ValoulouEtGab/PolyMecanum/Images/20240202_102125.jpg

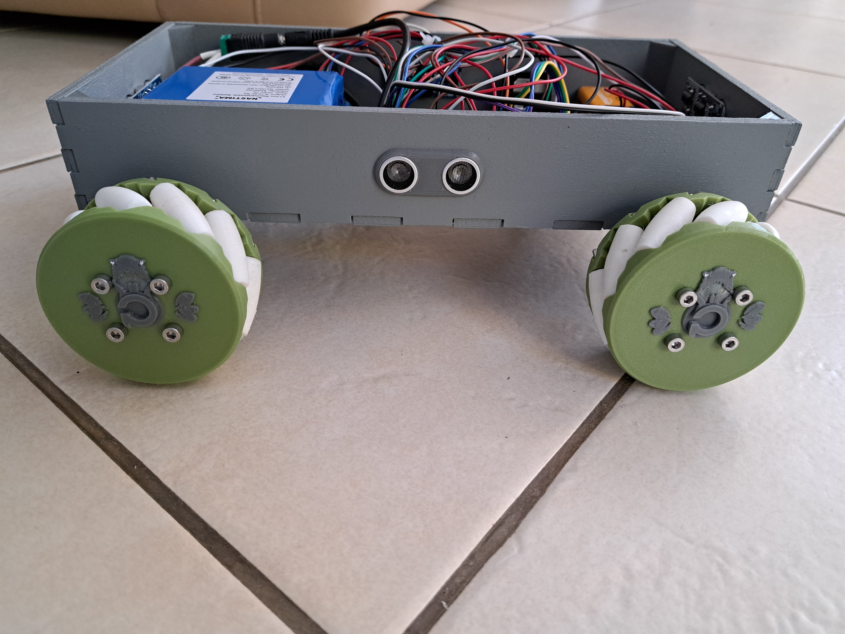
Images/20240202_102125.jpg
