ValoulouEtGab/PolyMecanum/README.md

# PolyMecanum
Plateforme contrôlée depuis un smartphone avec des roues "Mecanum".
