ValoulouEtGab/PolyMecanum/Rapport Final/Rapport Final PolyMecanum.pdf

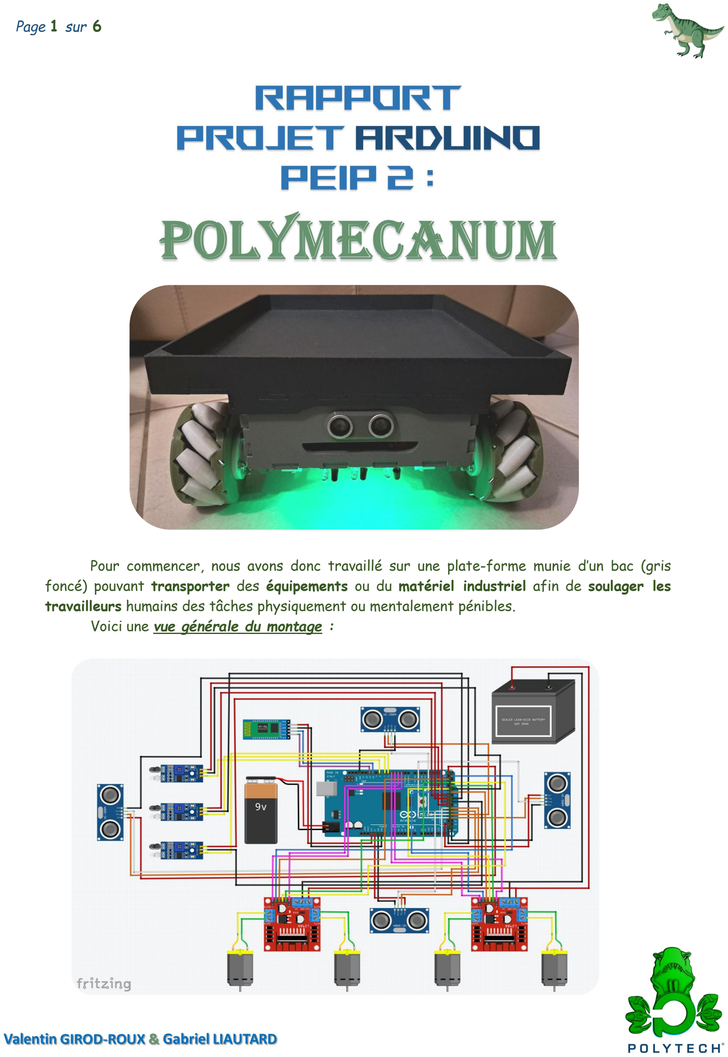
[picture p3: page 1]

Page 1 sur 6

Pour commencer, nous avons donc travaillé sur une plate-forme munie d’un bac (gris foncé) pouvant transporter des équipements ou du matériel industriel afin de soulager les travailleurs humains des tâches physiquement ou mentalement pénibles. Voici une vue générale du montage :

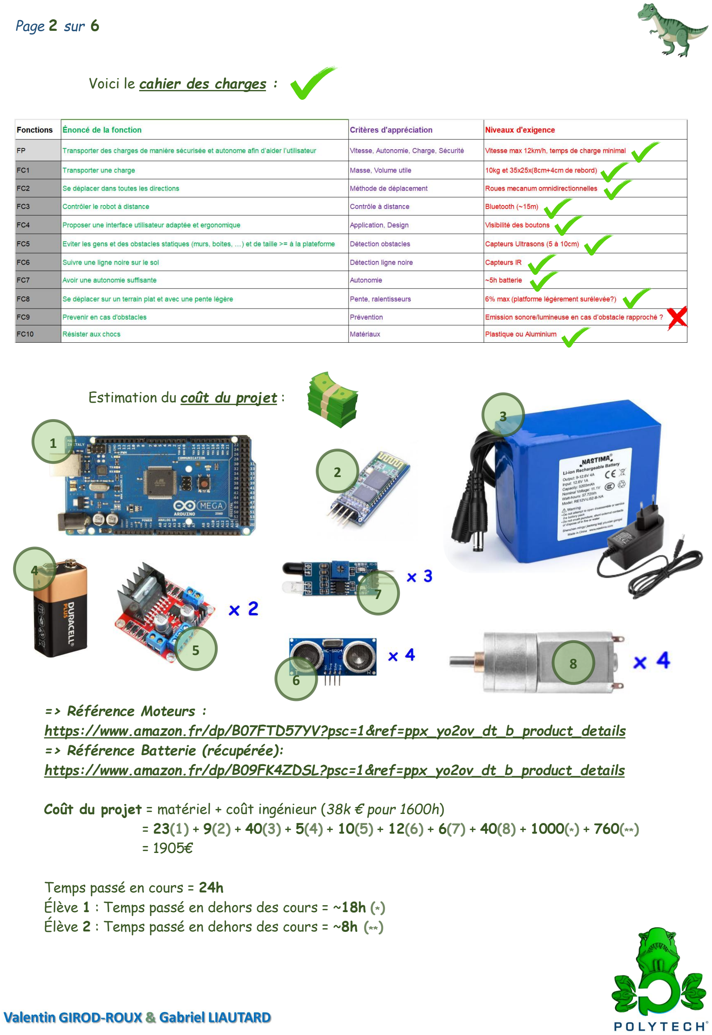
[picture p4: page 2]

Page 2 sur 6

Voici le cahier des charges :

Estimation du coût du projet :

=> Référence Moteurs :
https://www.amazon.fr/dp/B07FTD57YV?psc=1&ref=ppx_yo2ov_dt_b_product_details => Référence Batterie (récupérée):

https://www.amazon.fr/dp/B09FK4ZDSL?psc=1&ref=ppx_yo2ov_dt_b_product_details

Coût du projet = matériel + coût ingénieur (38k € pour 1600h) = 23(1) + 9(2) + 40(3) + 5(4) + 10(5) + 12(6) + 6(7) + 40(8) + 1000(*) + 760(**) = 1905€

Temps passé en cours = 24h
Élève 1 : Temps passé en dehors des cours = ~18h (*) Élève 2 : Temps passé en dehors des cours = ~8h (**)

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
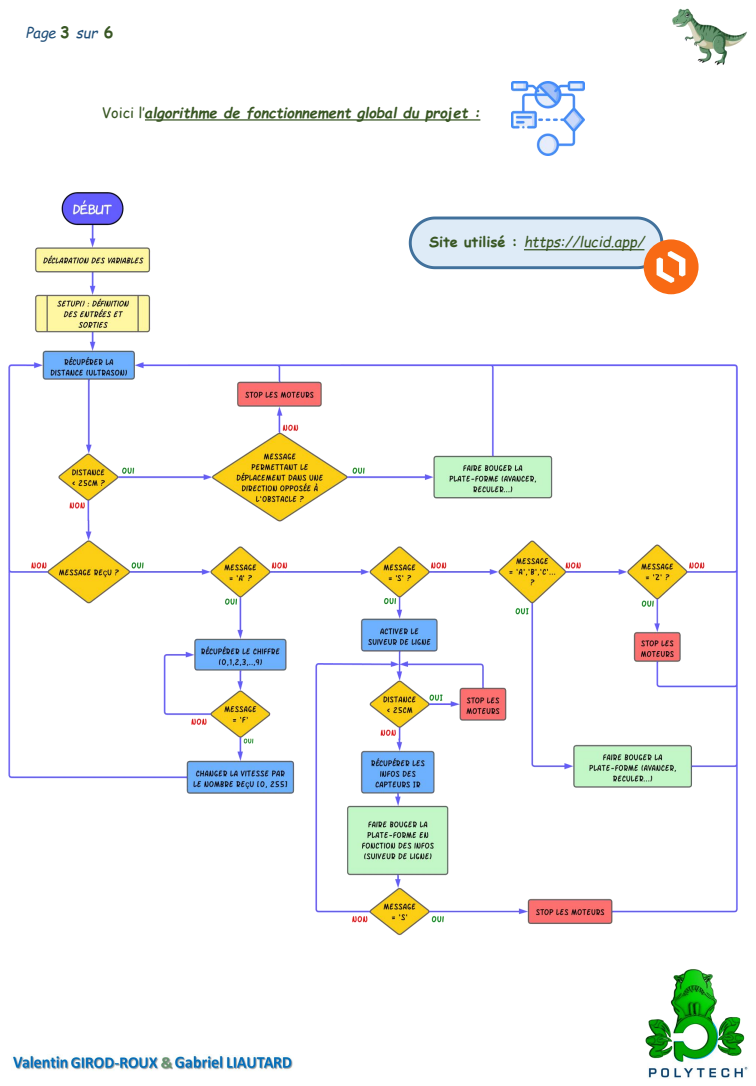
[picture p5: page 3]
Page 3 sur 6

Voici l’algorithme de fonctionnement global du projet :

Site utilisé : https://lucid.app/

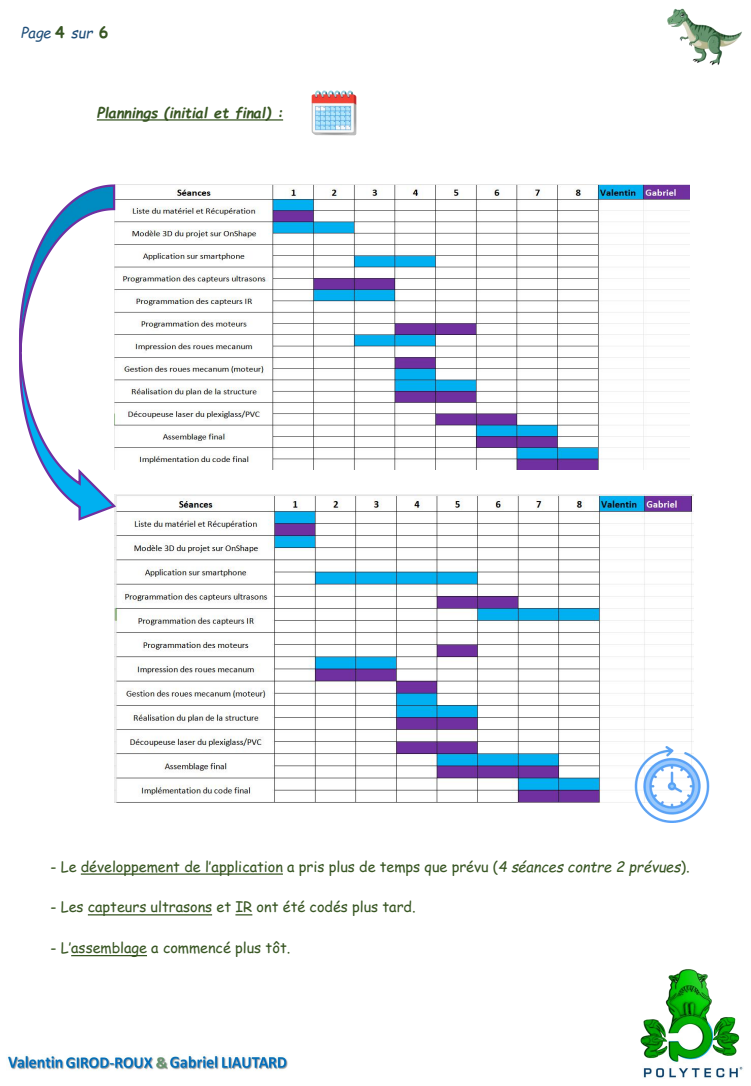
[picture p6: page 4]
Page 4 sur 6

Plannings (initial et final) :

- Le développement de l’application a pris plus de temps que prévu (4 séances contre 2 prévues). - Les capteurs ultrasons et IR ont été codés plus tard. - L’assemblage a commencé plus tôt.

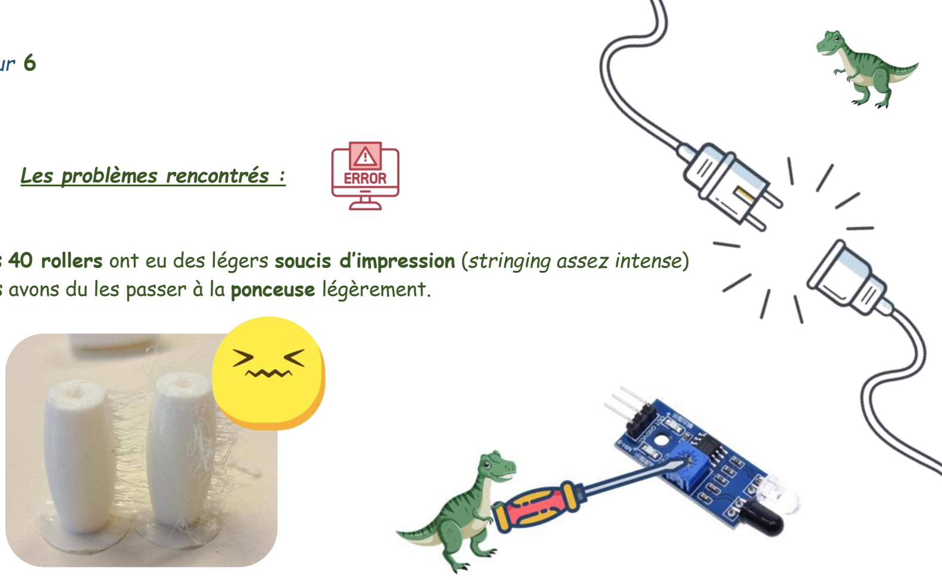
[picture p7: figure]
Les problèmes rencontrés :

Page 5 sur 6

- Les 40 rollers ont eu des légers soucis d’impression (stringing assez intense) Nous avons du les passer à la ponceuse légèrement.
- Le réglage des capteurs IR étaient trop sensibles avec le potentiomètre et 1 des capteurs ne fonctionnait pas car il manquait une LED. - Lorsque nous faisions rouler la plate-forme dans le couloir, les roues se détachaient de l’axe

du moteur donc nous avons rajouté une vis afin de serrer celui-ci.

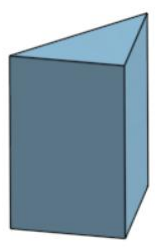
[picture p8: figure]
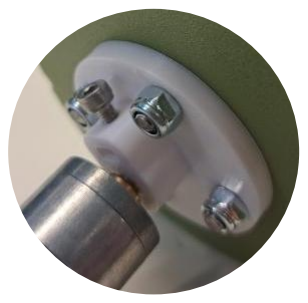
[picture p9: figure]

- Afin de rigidifier la structure nous avons rajouté des triangles en TPU dans les angles. - Il n’y avait plus de pins 5V donc nous avons branché les alimentations des capteurs sur des

pins digitaux (0/1) et nous les avons mis en HIGH. - Les capteurs ne fonctionnaient plus

à cause du manque de voltage de la pile 9V.

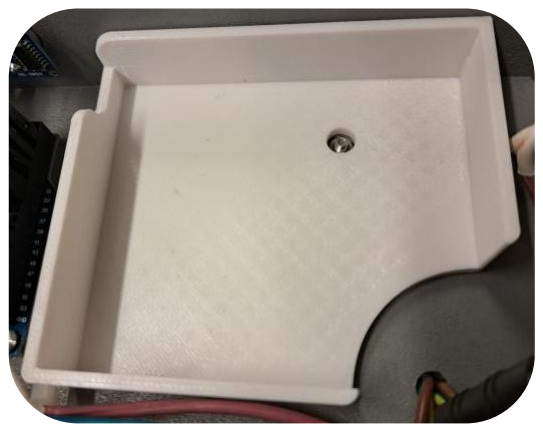
[picture p10: figure]

- La batterie faisait du bruit lors du déplacement donc nous avons imprimé un support en PLA. - Le bac faisait également du bruit donc nous avons recouvert tout le tour de feutrine.

Page 6 sur 6

Bibliographie :

Le design des roues a été pris sur : https://howtomechatronics.com/projects/arduino-mecanum-wheels-robot/
L’application a été réalisé sur : https://appinventor.mit.edu/

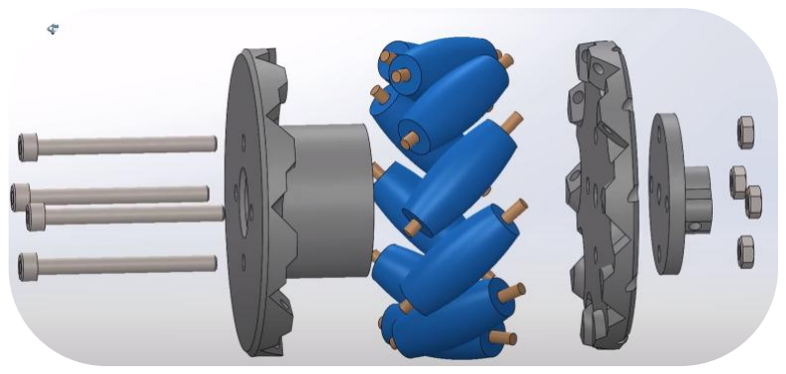
[picture p11: figure]

# CONCLUSION :

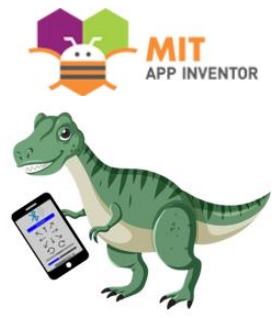
[picture p12: figure]

En résumé, notre projet nous a permis de mettre en pratique les compétences acquises en PEIP dans les différentes matières. L'utilisation de ce type de roue, d'un contrôle à distance, d'une détection d'obstacles et

d’un suiveur de ligne rend ce système polyvalent, adapté aussi bien à des applications industrielles que domotiques. Enfin, pour améliorer le suiveur de ligne, une caméra pourrait servir à prévoir les virages plus

précisément. Si nous avions eu encore plus de temps, nous arions pu monter à l’arrière un bras avec des servomoteurs et une pince afin de récupérer les équipements. Nous arions pu aussi implémenter de l’IA pour éviter les obstacles de manière autonome.

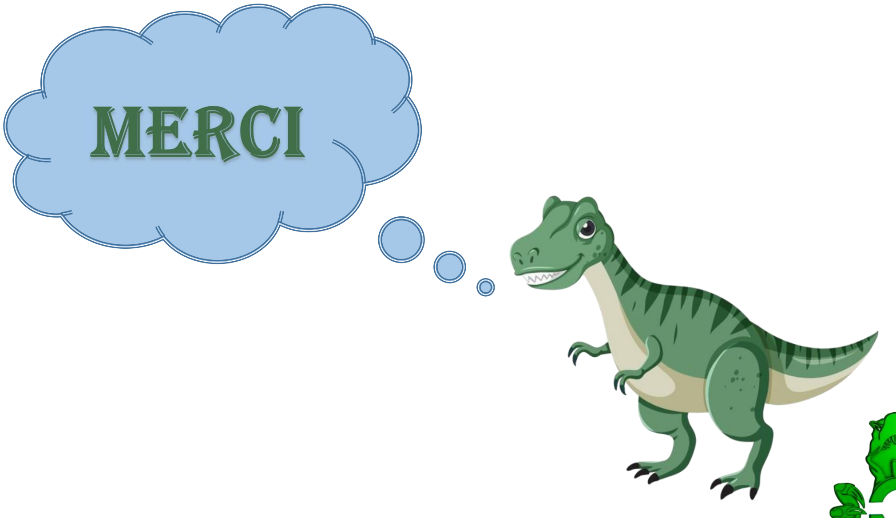
[picture p13: figure]
