ValoulouEtGab/PolyMecanum/Rapports de seances/7 - GIROD-ROUX.pdf

## RAPPORT DE SEANCE 7 :

Durant la septième séance nous avons installé les capteurs infrarouges en dessous de la plate-forme à l’avant. Nous les avons vissés et branchés sur les pins de la carte arduino.

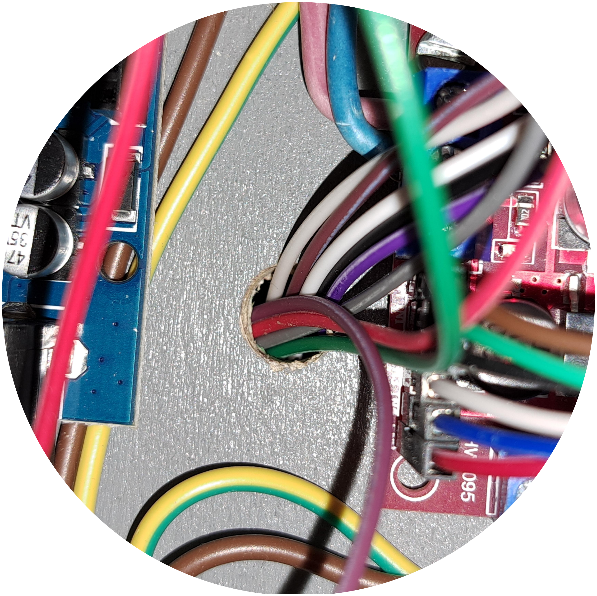
[picture p14: figure]
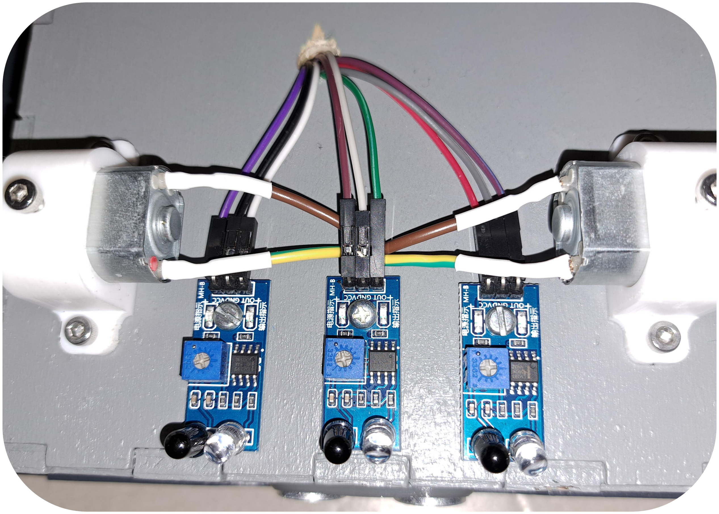
[picture p15: figure]
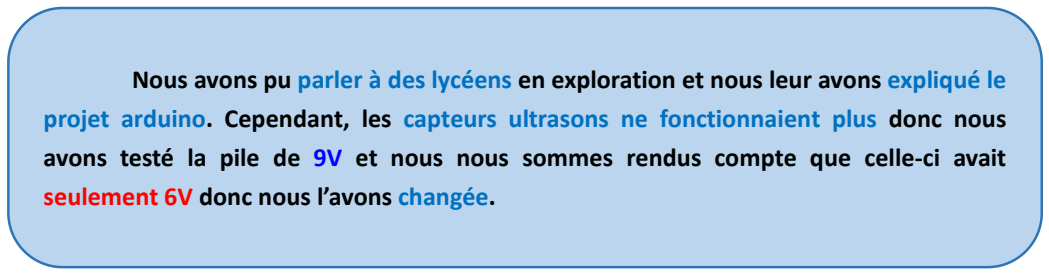
[picture p16: figure]
seulement 6V donc nous l’avons changée.

Nous avons pu parler à des lycéens en exploration et nous leur avons expliqué le projet arduino. Cependant, les capteurs ultrasons ne fonctionnaient plus donc nous avons testé la pile de 9V et nous nous sommes rendus compte que celle-ci avait

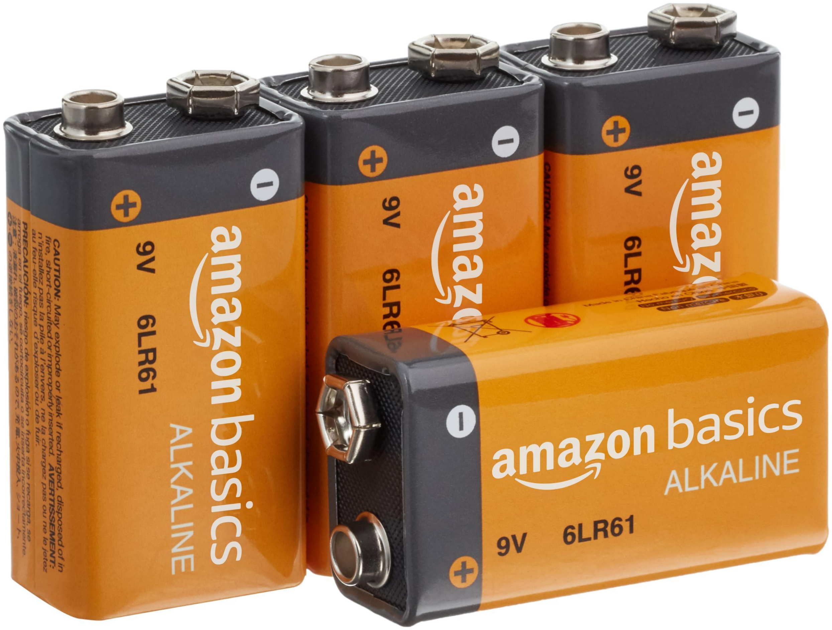
[picture p17: figure]
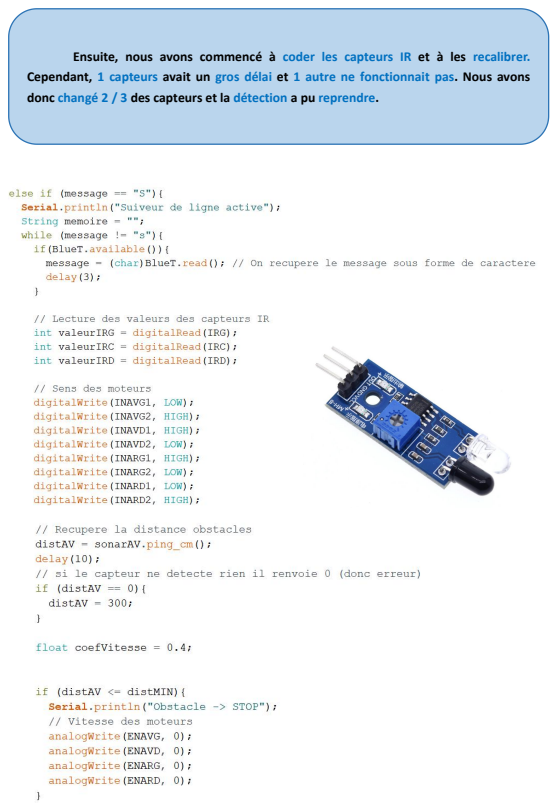
[picture p18: page 2]

Ensuite, nous avons commencé à coder les capteurs IR et à les recalibrer. Cependant, 1 capteurs avait un gros délai et 1 autre ne fonctionnait pas. Nous avons

donc changé 2 / 3 des capteurs et la détection a pu reprendre.

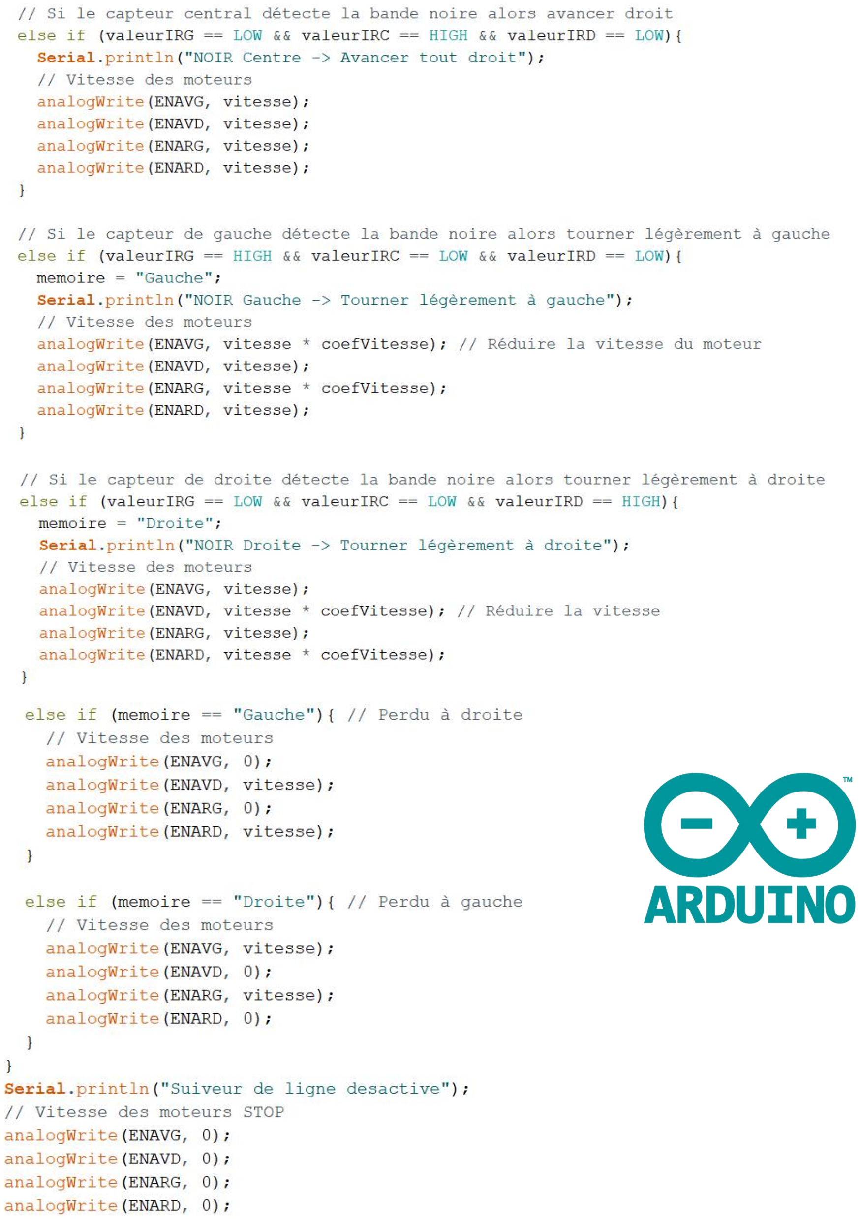
[picture p19: figure]
