ValoulouEtGab/PolyMecanum/Rapports de seances/2_LIAUTARD.pdf

## RAPPORT DE SEANCE 2 :

J’ai commencé à combiner les codes que nous avions pour la voiture (code moteur, code capteur ultrasons, code infrarouge pour suivre ligne noire, module bluetooth) de manière à les réorganiser pour pouvoir remplir notre cahier des charges, c’est à dire : pouvoir avoir un véhicule qui s’arrête s’il s’approche trop près d’un mur, qu’il y ait un mode permettant de suivre un chemin tout tracé via une ligne noire au sol, et que le véhicule puisse être contrôlable à distance. Etant donné que nous avons 4 capteurs ultrasons, 3 capteurs infrarouges et un

module bluetooth, combiner le tout est une tâche ardue qui va prendre du temps et nécessiter beaucoup de concentration pour recoller les morceaux :

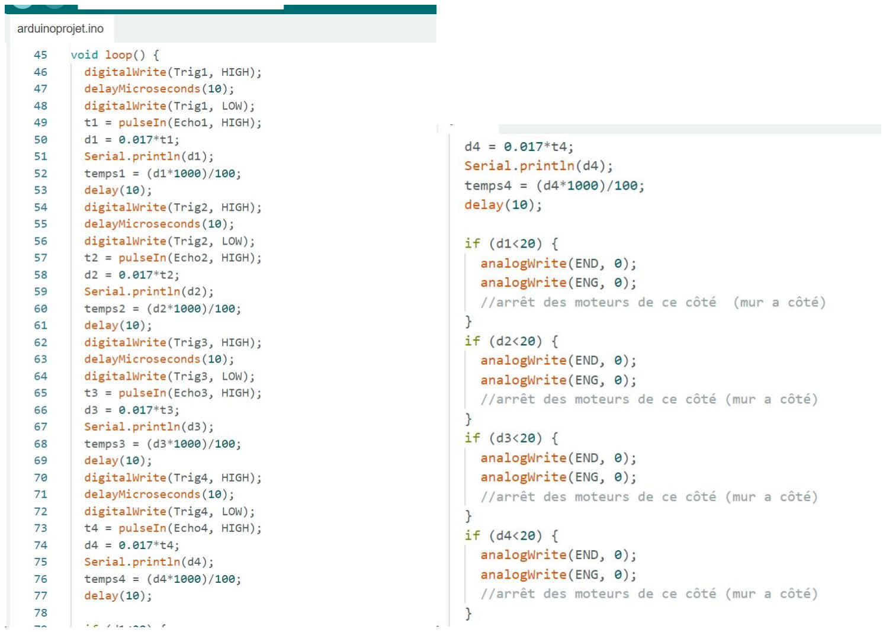
[picture p39: figure]

Nous sommes allés au Fab Lab afin de lancer l’impression des roues mecanum. Nous avons décidé d’imprimer la structure des roues en PLA (plastique dur, résistant) et les rollers en TPU (plastique flexible avec une meilleure adhérence au sol).

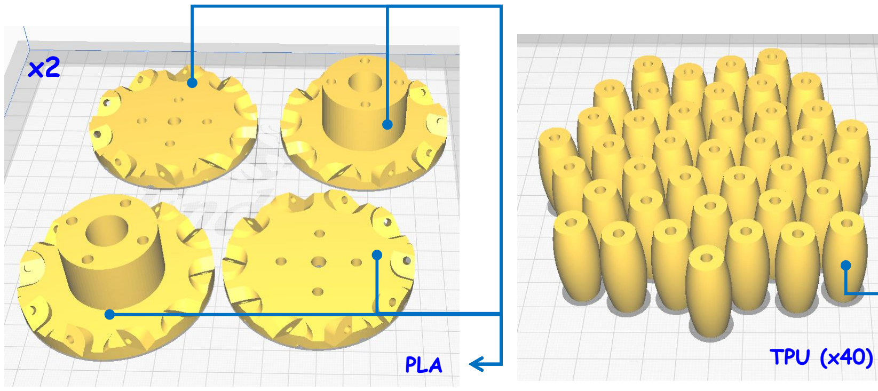
[picture p40: figure]
TPU (x40) PLA
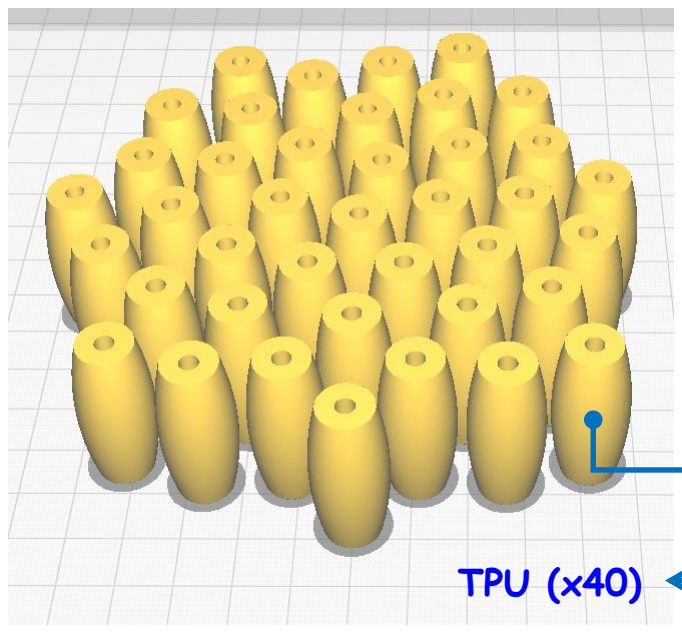
[picture p41: figure]

Nous nous sommes servis du logiciel Prusa afin de positionner les différentes parties sur le plateau. Les quatre roues munies de son armée de 40 rollers prennent environ 20h d’impression !

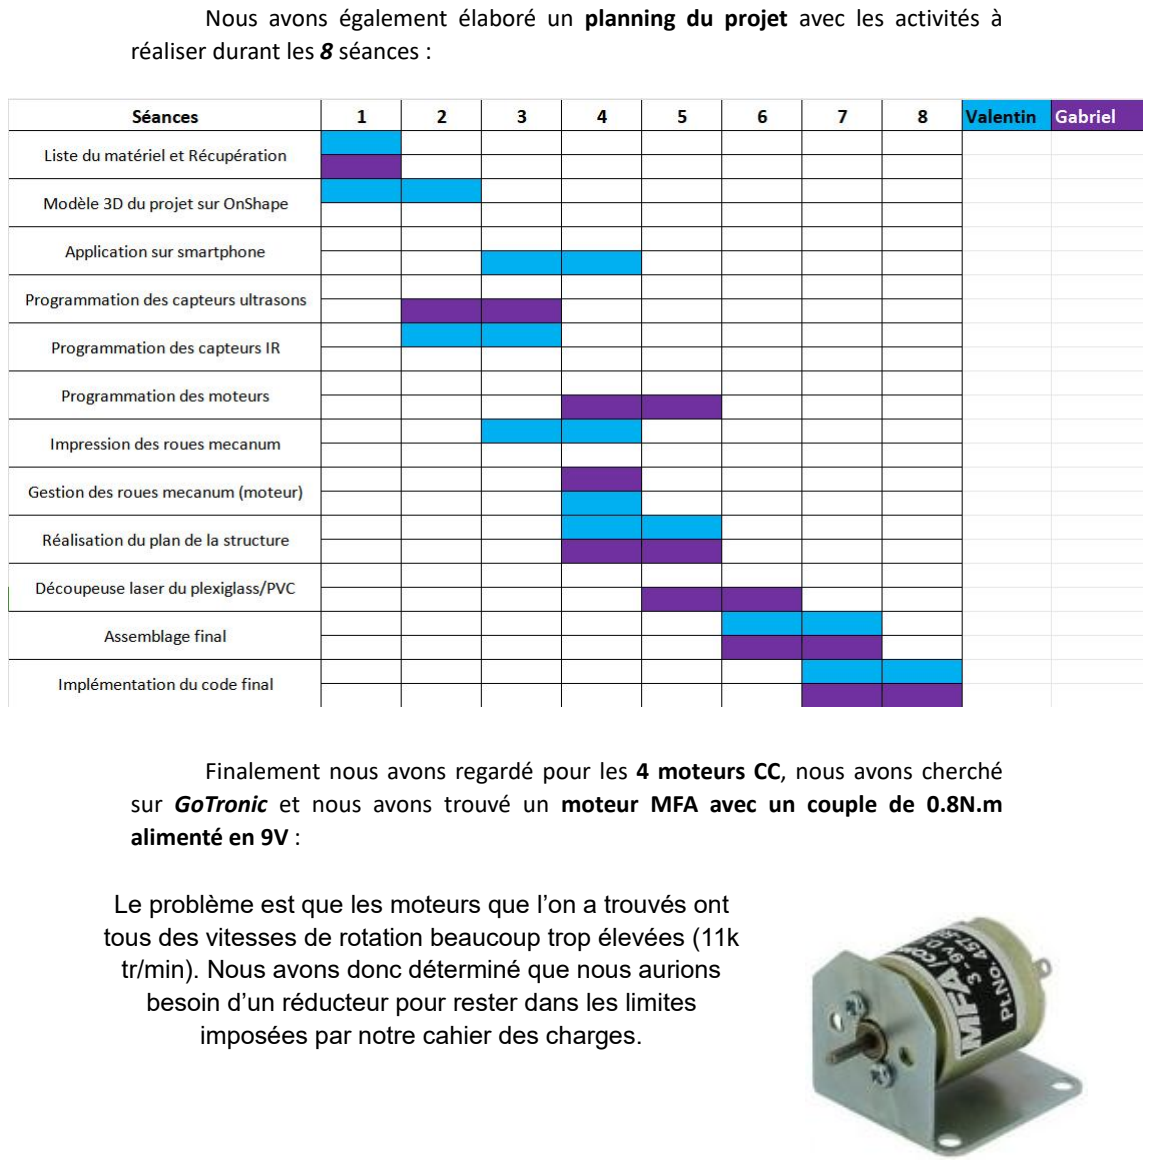
[picture p42: page 3]

Nous avons également élaboré un planning du projet avec les activités à réaliser durant les 8 séances :

Finalement nous avons regardé pour les 4 moteurs CC, nous avons cherché sur GoTronic et nous avons trouvé un moteur MFA avec un couple de 0.8N.m alimenté en 9V :

Le problème est que les moteurs que l’on a trouvés ont
tous des vitesses de rotation beaucoup trop élevées (11k
tr/min). Nous avons donc déterminé que nous aurions besoin d’un réducteur pour rester dans les limites imposées par notre cahier des charges.
