ValoulouEtGab/PolyMecanum/Rapports de seances/2 - GIROD-ROUX.pdf

## RAPPORT DE SEANCE 2 :

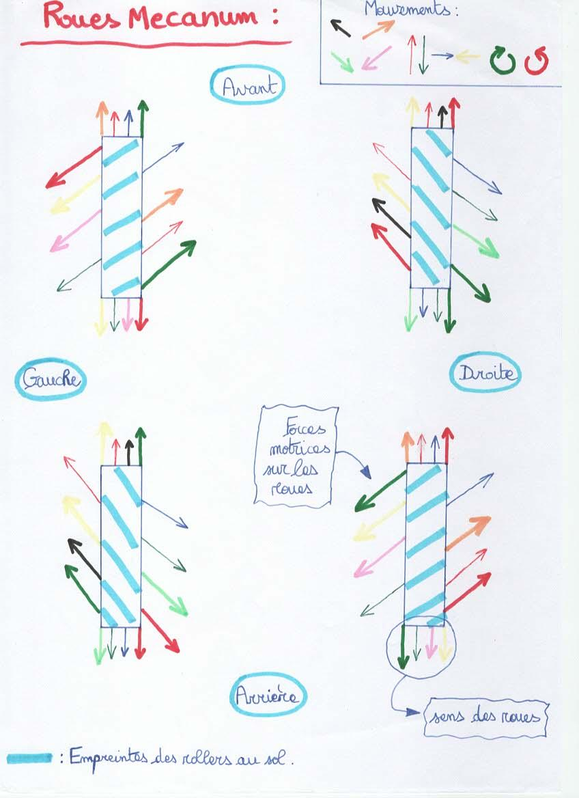
[picture p43: page 1]

Durant la deuxième séance j’ai étudié le fonctionnement des roues mecanum pour la gestion de rotation des moteurs :

x2

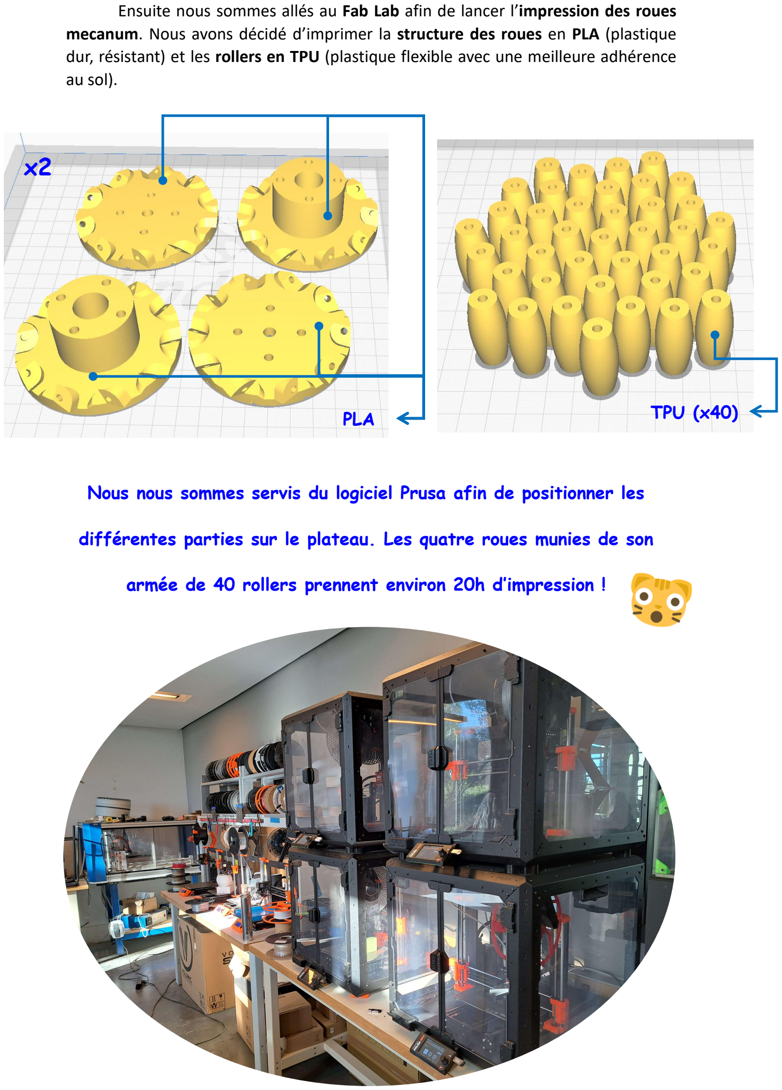
[picture p44: page 2]

Ensuite nous sommes allés au Fab Lab afin de lancer l’impression des roues mecanum. Nous avons décidé d’imprimer la structure des roues en PLA (plastique dur, résistant) et les rollers en TPU (plastique flexible avec une meilleure adhérence au sol).

Nous nous sommes servis du logiciel Prusa afin de positionner les

différentes parties sur le plateau. Les quatre roues munies de son

armée de 40 rollers prennent environ 20h d’impression !

TPU (x40) PLA

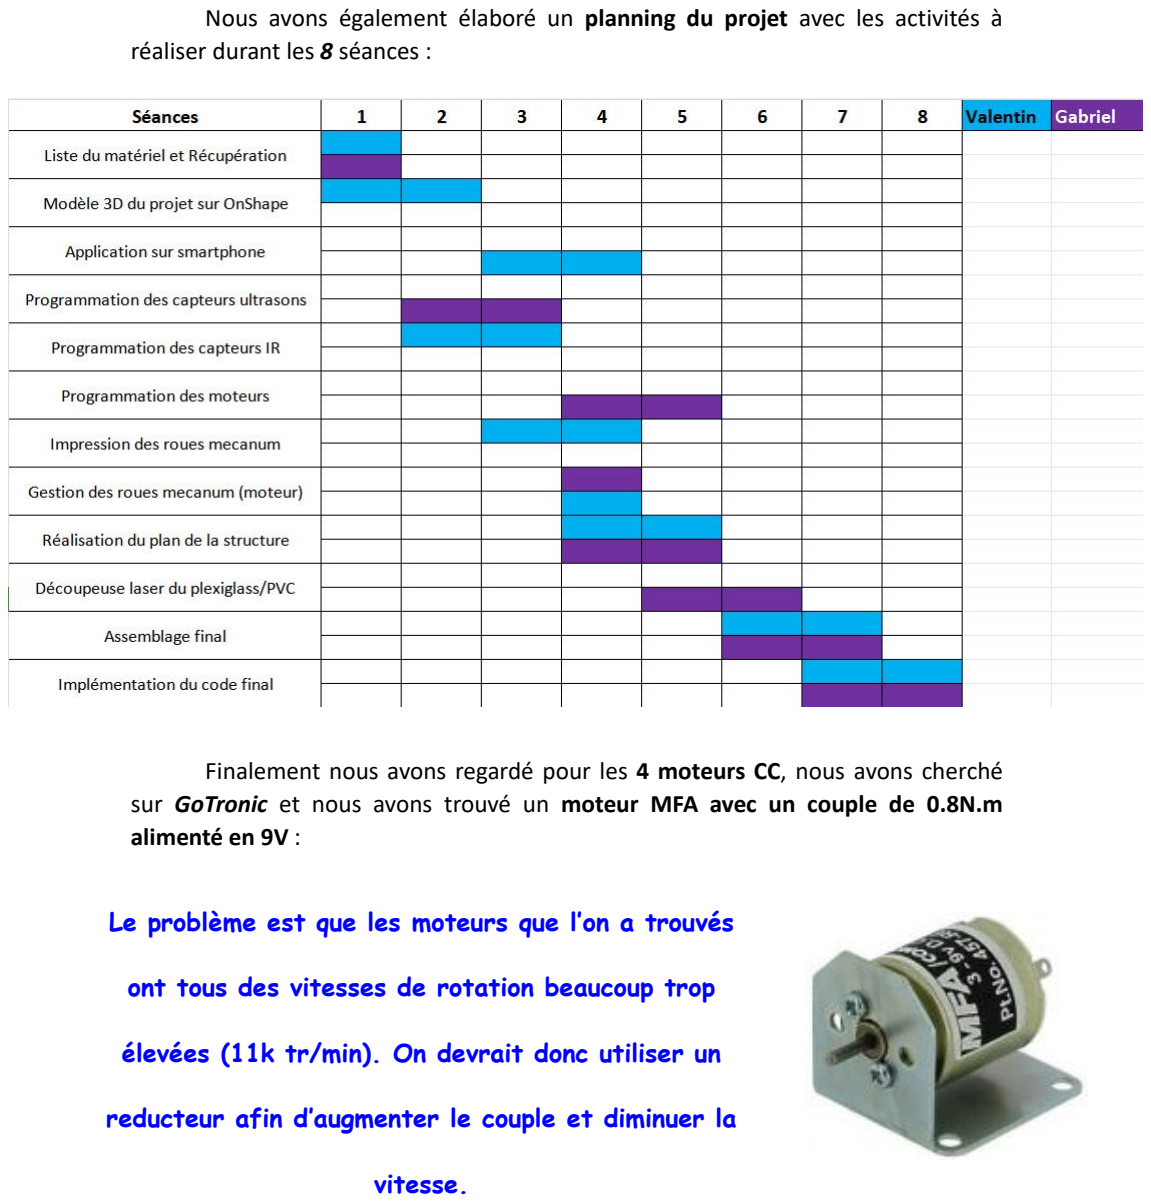
[picture p45: page 3]

Nous avons également élaboré un planning du projet avec les activités à réaliser durant les 8 séances :

Finalement nous avons regardé pour les 4 moteurs CC, nous avons cherché sur GoTronic et nous avons trouvé un moteur MFA avec un couple de 0.8N.m alimenté en 9V :

Le problème est que les moteurs que l’on a trouvés

ont tous des vitesses de rotation beaucoup trop

élevées (11k tr/min). On devrait donc utiliser un

reducteur afin d’augmenter le couple et diminuer la

vitesse.

J’ai également commencé à réaliser l’application avec le site "AppInventor" qui permettra de contrôler la plate-forme à distance.

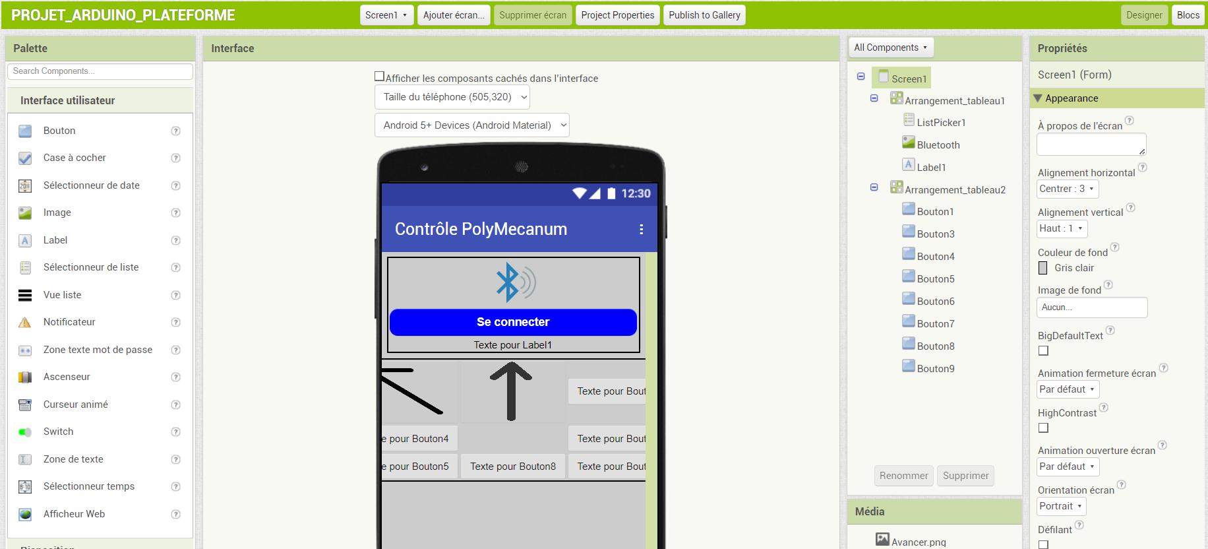
[picture p46: figure]
