ValoulouEtGab/PolyMecanum/Rapports de seances/1-LIAUTARD.pdf

## RAPPORT DE SEANCE 1 :

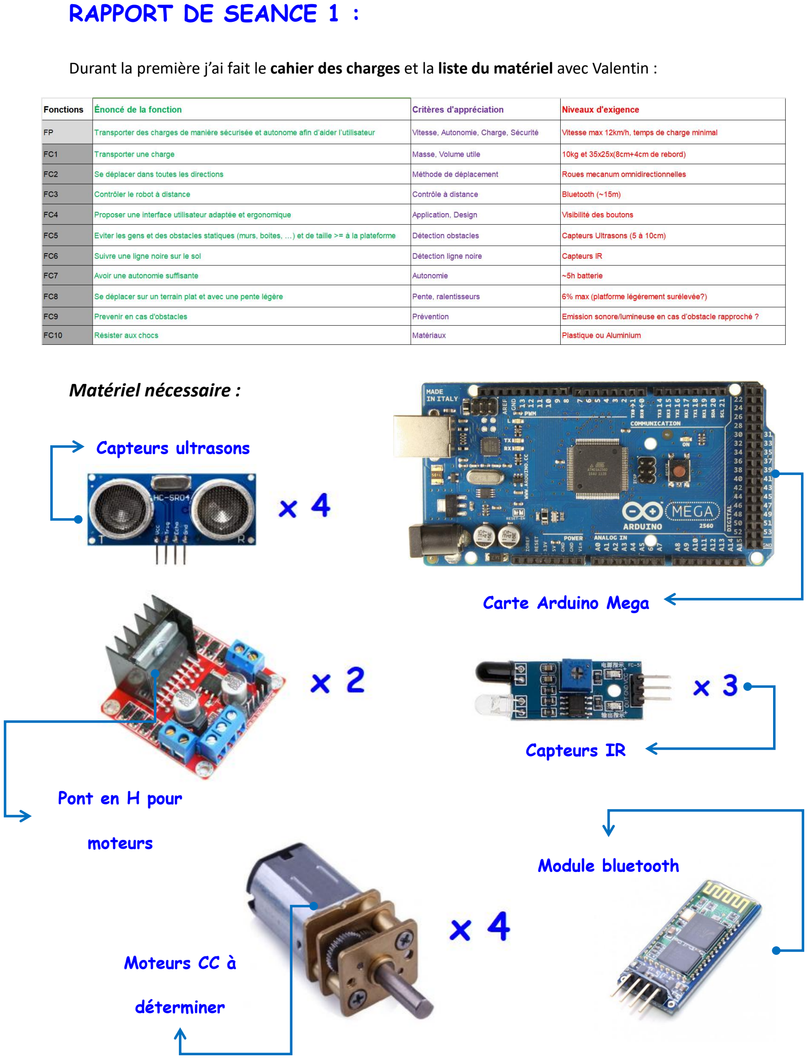
[picture p47: page 1]

Durant la première j’ai fait le cahier des charges et la liste du matériel avec Valentin :

### Matériel nécessaire :

Moteurs CC à

déterminer

Pont en H pour

moteurs
Module bluetooth

Capteurs IR

Carte Arduino Mega

Capteurs ultrasons

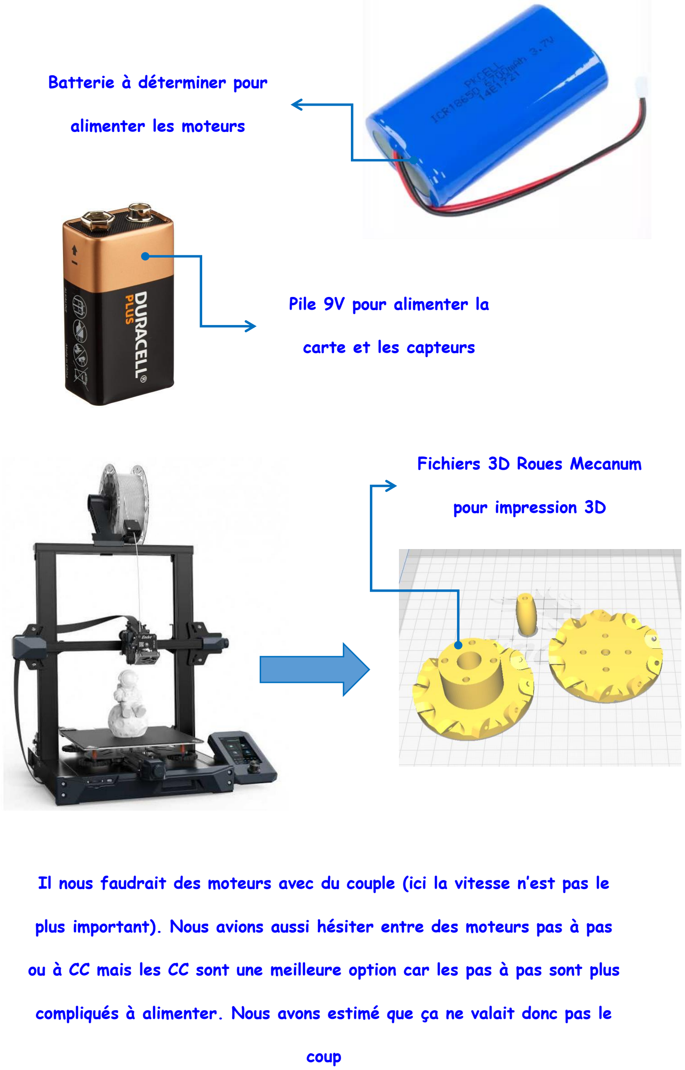
[picture p48: page 2]

Pile 9V pour alimenter la

carte et les capteurs

Batterie à déterminer pour

alimenter les moteurs

Fichiers 3D Roues Mecanum

pour impression 3D

Il nous faudrait des moteurs avec du couple (ici la vitesse n’est pas le

plus important). Nous avions aussi hésiter entre des moteurs pas à pas

ou à CC mais les CC sont une meilleure option car les pas à pas sont plus

compliqués à alimenter. Nous avons estimé que ça ne valait donc pas le

coup

Bien que c’était Valentin qui se chargeait de la modélisation OneShape, nous nous penchions tout les deux sur le problème : mesure des composants pour pouvoir reporter leur taille dans le logiciel, comment organiser l’espace et agencer les composants de manière à pouvoir avoir un produit fini compact (plus petit volume -> moins de matière -> masse du système réduite -> la masse de la charge transportée peut être plus élevée) également nous avons pensé a aménager la boite de manière a pouvoir positionner les roues plus bas. Enfin, étant donné que nous n’avions pas encore les moteurs, j’ai rassemblé des fils de même

couleurs et les ait cablé sur les composants, de manière à ce que lors des prochaines séances, assembler | les | composants | ensemble | devienne | une | tâche | plus | simple

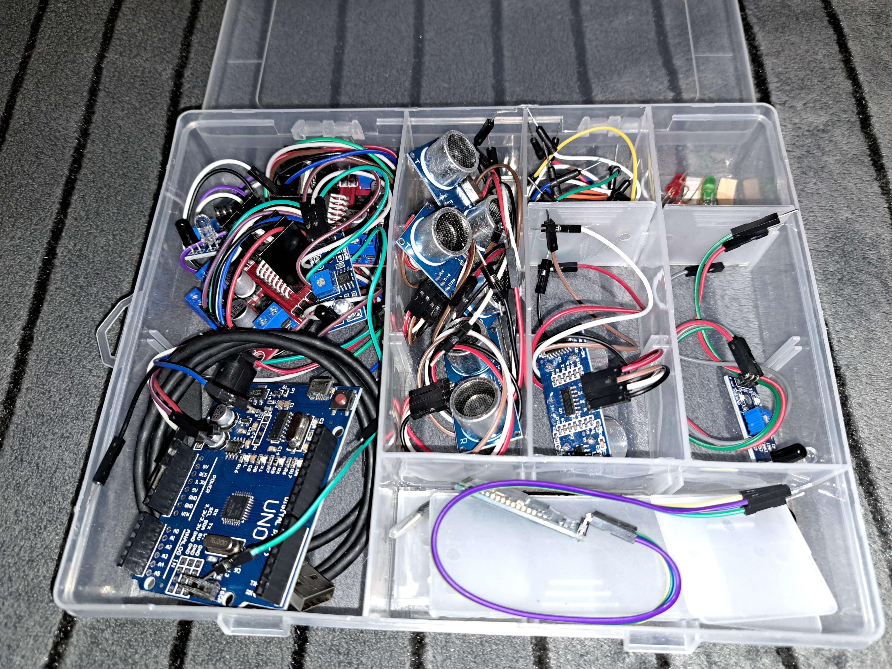
[picture p49: figure]

En somme, dans cette séance nous avons, à deux, pensé et imaginé notre

projet pour le retranscrire en 3D de manière virtuelle.
