ValoulouEtGab/PolyMecanum/Images/20240108_152602.jpg

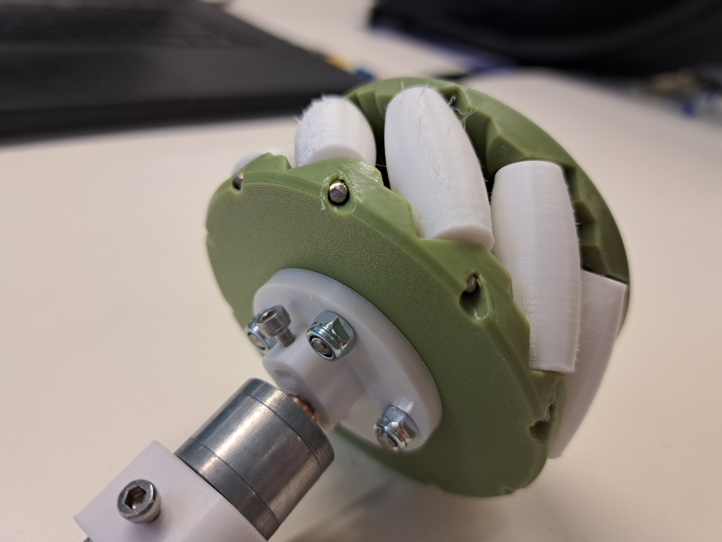
Images/20240108_152602.jpg
