ValoulouEtGab/PolyMecanum/Images/20240115_151331.jpg

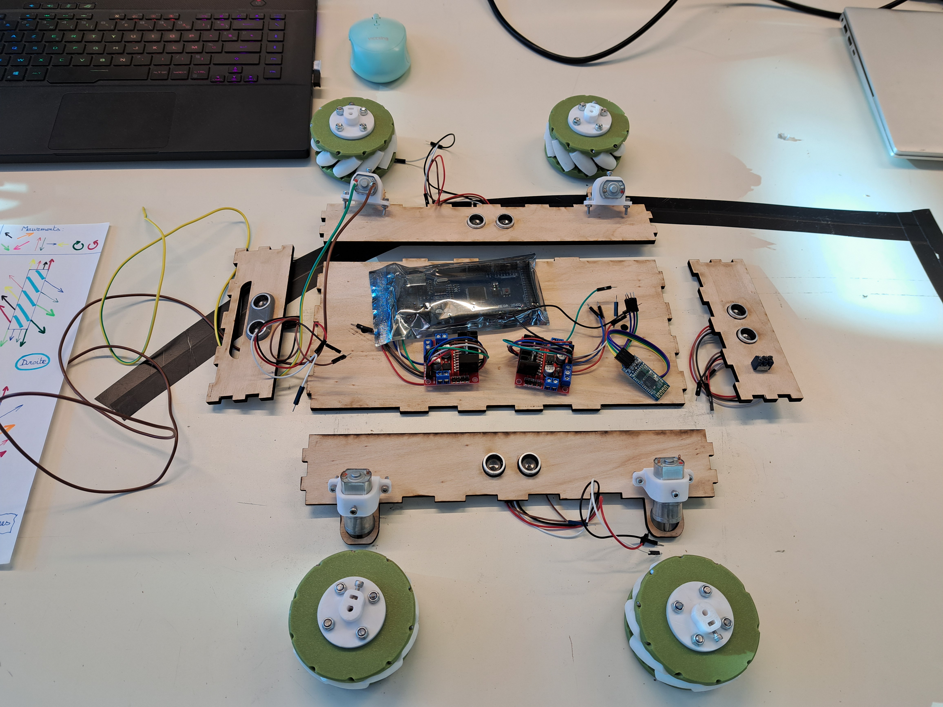
Images/20240115_151331.jpg
