ValoulouEtGab/PolyMecanum/Images/image_2024-02-27_185253469-removebg-preview.png

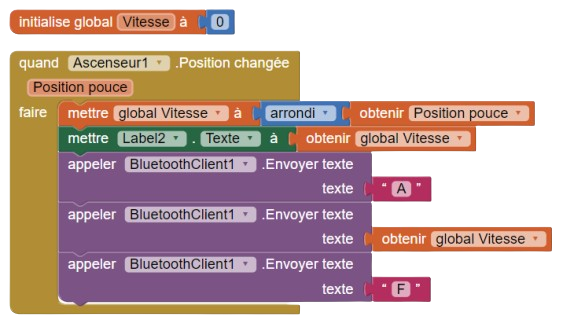
Images/image_2024-02-27_185253469-removebg-preview.png
