ValoulouEtGab/PolyMecanum/Images/Screenshot_20240227-193318.png

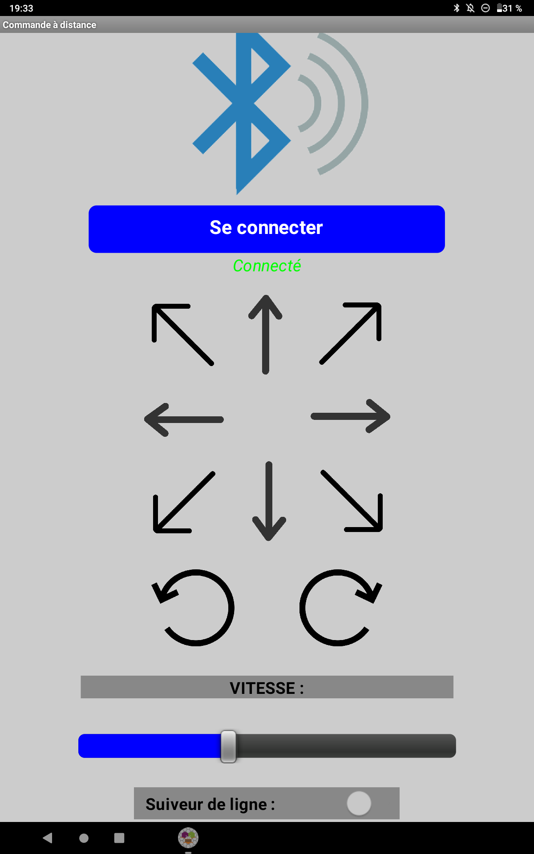
Images/Screenshot_20240227-193318.png
