ValoulouEtGab/PolyMecanum/Programmation/Algo Projet PolyMecanum.png

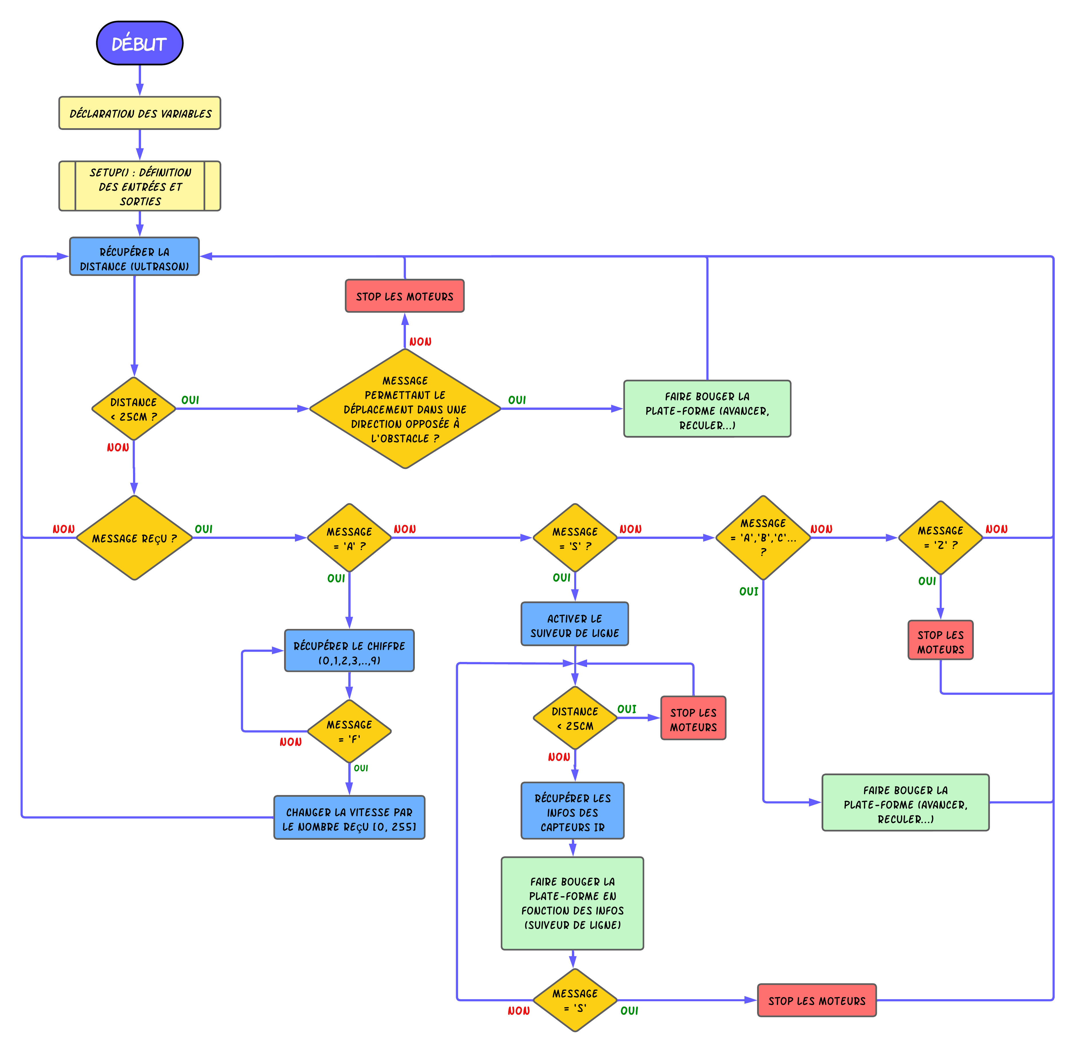
Programmation/Algo Projet PolyMecanum.png
