ValoulouEtGab/PolyMecanum/Modélisation/Plateforme/PolyMecanum_Bac.dxf

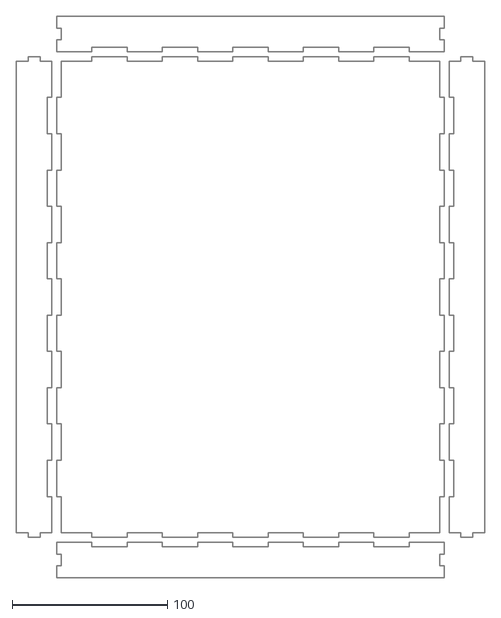
[picture p61: CAD file, 2024-03-14]
Modélisation/Plateforme/PolyMecanum_Bac.dxf
302.0 x 362.0
