ValoulouEtGab/PolyMecanum/Modélisation/Roue Suédoise 3D/Capuchon Roues Meca Big.stl

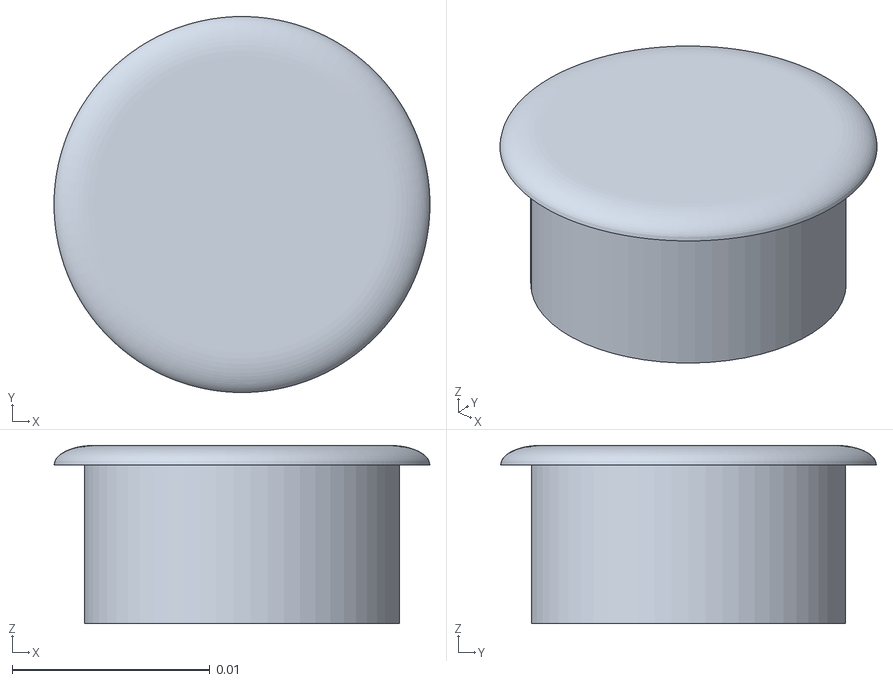
[picture p62: CAD file, 2024-03-14]
Modélisation/Roue Suédoise 3D/Capuchon Roues Meca Big.stl
0.019 x 0.019 x 0.009
