ValoulouEtGab/PolyMecanum/Modélisation/Plateforme/Plateforme PolyMecanum.dxf

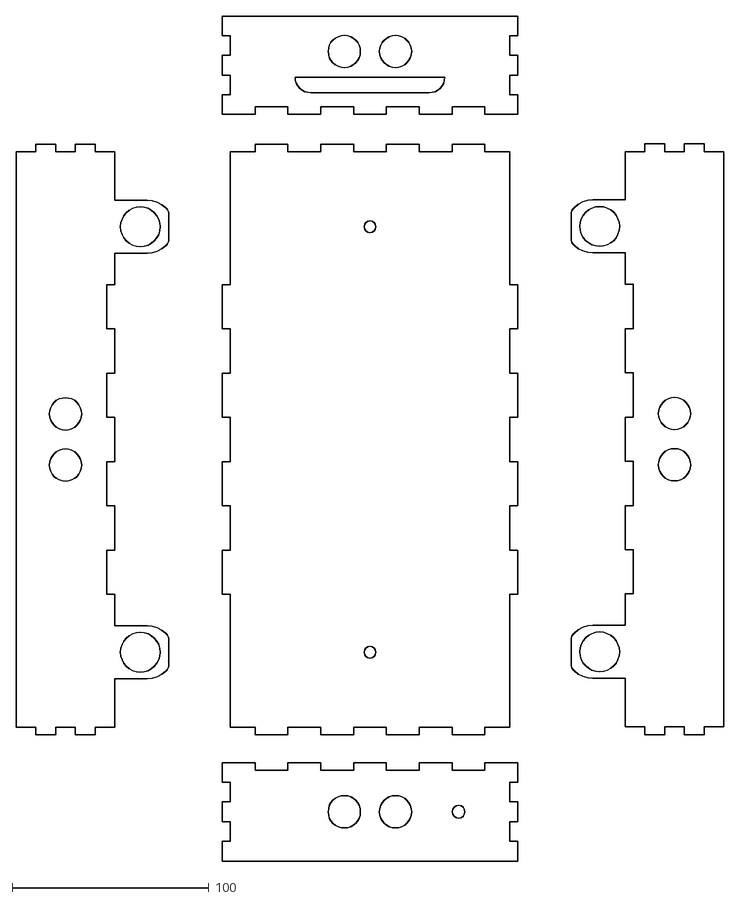
[picture p63: CAD file, 2024-03-14]
Modélisation/Plateforme/Plateforme PolyMecanum.dxf
359.2 x 429.0
