ValoulouEtGab/PolyMecanum/Modélisation/Roue Suédoise 3D/Coupleur moteur CC.stl

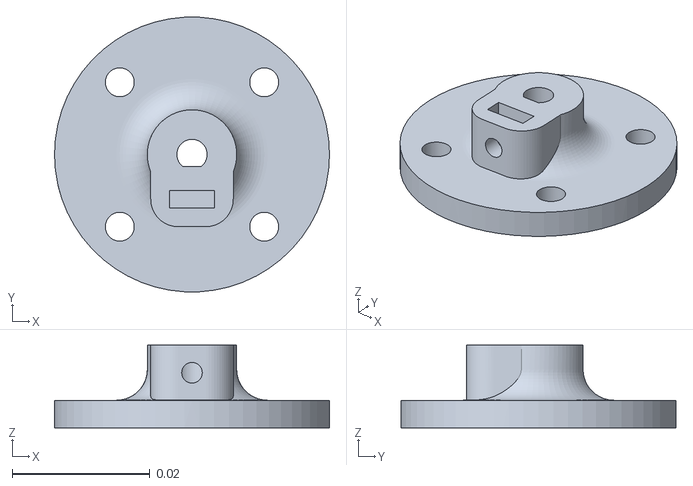
[picture p64: CAD file, 2024-03-14]
Modélisation/Roue Suédoise 3D/Coupleur moteur CC.stl
0.04 x 0.04 x 0.012
