ValoulouEtGab/PolyMecanum/Modélisation/Plateforme/POLYTECH LOGO DINO.stl

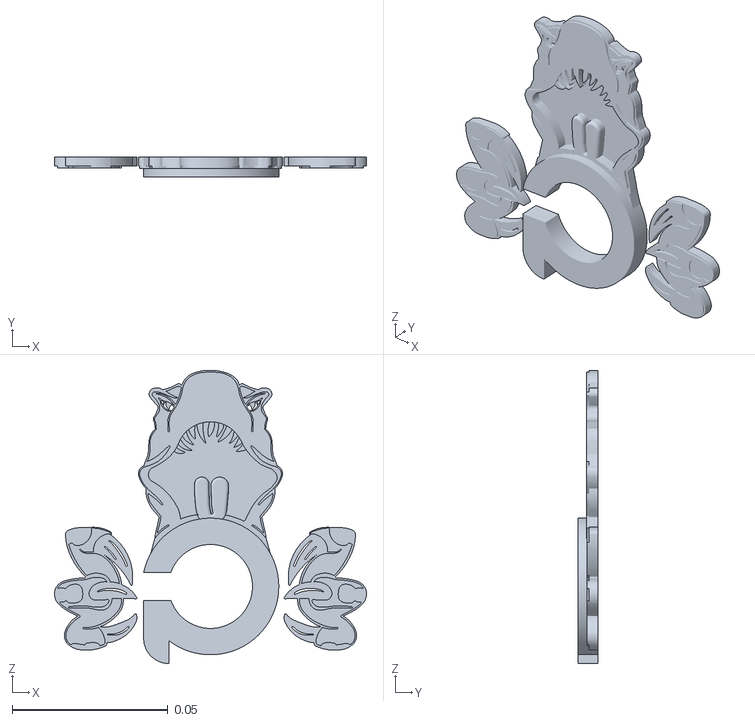
[picture p65: CAD file, 2024-03-14]
Modélisation/Plateforme/POLYTECH LOGO DINO.stl
0.1 x 0.0065 x 0.094
