ValoulouEtGab/PolyMecanum/Modélisation/Roue Suédoise 3D/Support Moteur CC.stl

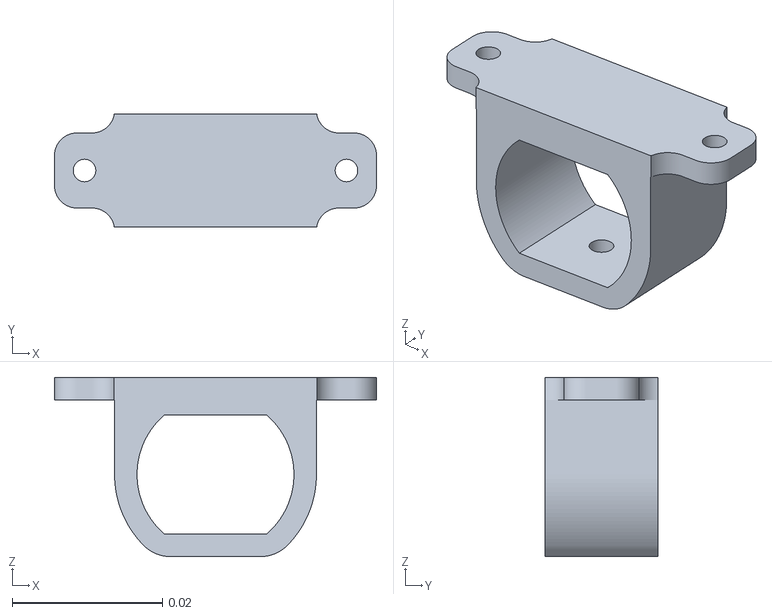
[picture p66: CAD file, 2024-01-09]
Modélisation/Roue Suédoise 3D/Support Moteur CC.stl
0.0429 x 0.015 x 0.0239
