ValoulouEtGab/PolyMecanum/Modélisation/Plateforme/PolyMecanum_Couvercle.dxf

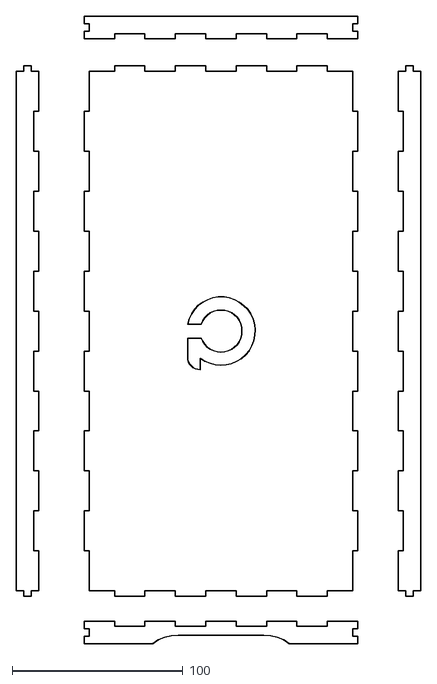
[picture p67: CAD file, 2024-03-14]
Modélisation/Plateforme/PolyMecanum_Couvercle.dxf
236.3 x 366.8
