ValoulouEtGab/PolyMecanum/Modélisation/Roue Suédoise 3D/Roue face int D.STL

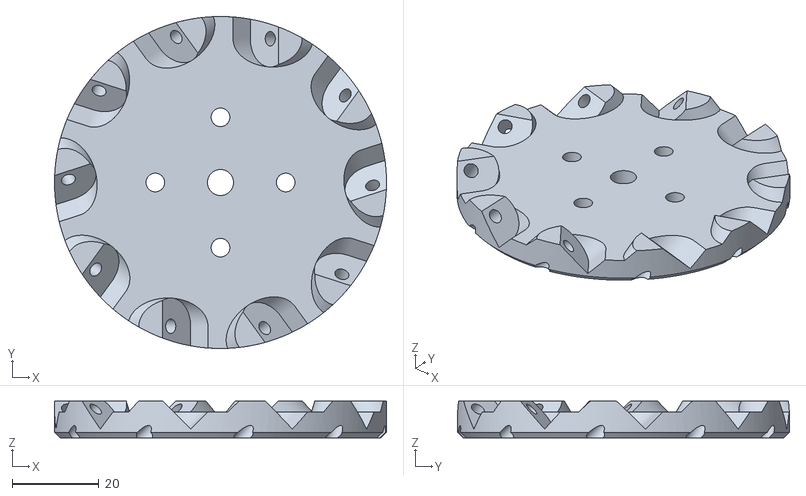
[picture p68: CAD file, 2023-12-12]
Modélisation/Roue Suédoise 3D/Roue face int D.STL
76.4 x 76.4 x 8.50
