ValoulouEtGab/PolyMecanum/Modélisation/Plateforme/Triangles Petits PolyMecanum.stl

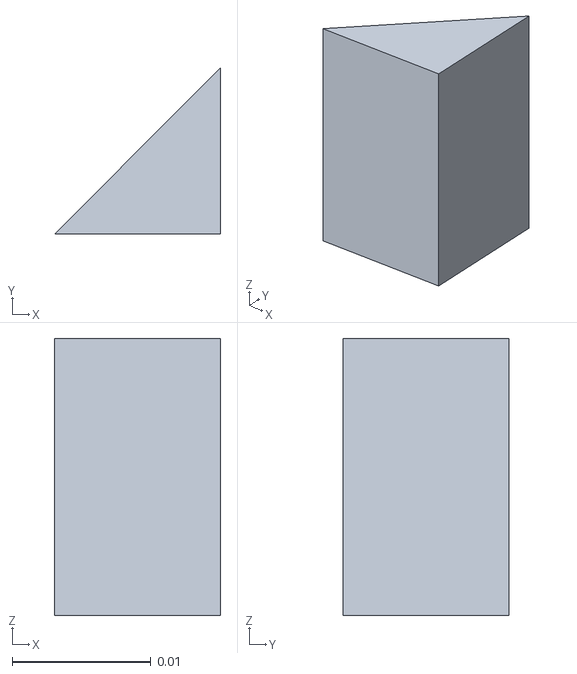
[picture p69: CAD file, 2024-03-14]
Modélisation/Plateforme/Triangles Petits PolyMecanum.stl
0.012 x 0.012 x 0.02
