ValoulouEtGab/PolyMecanum/Modélisation/Plateforme/Support Bat.stl

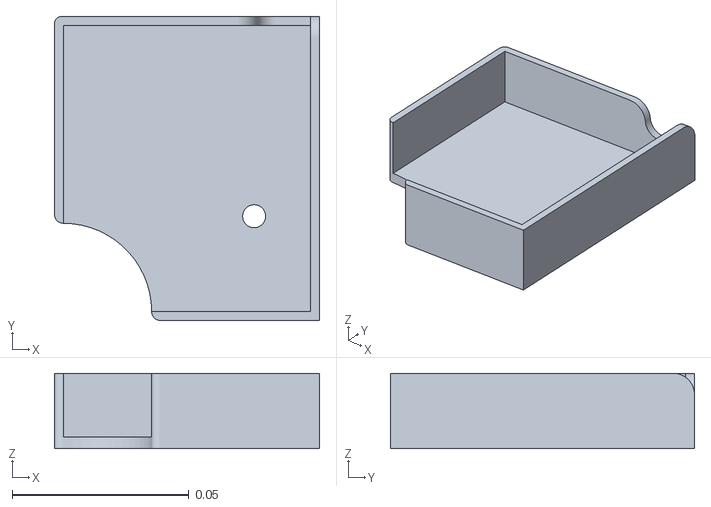
[picture p70: CAD file, 2024-03-14]
Modélisation/Plateforme/Support Bat.stl
0.075 x 0.086 x 0.0213
