ValoulouEtGab/PolyMecanum/Modélisation/Roue Suédoise 3D/Roue face ext G.STL

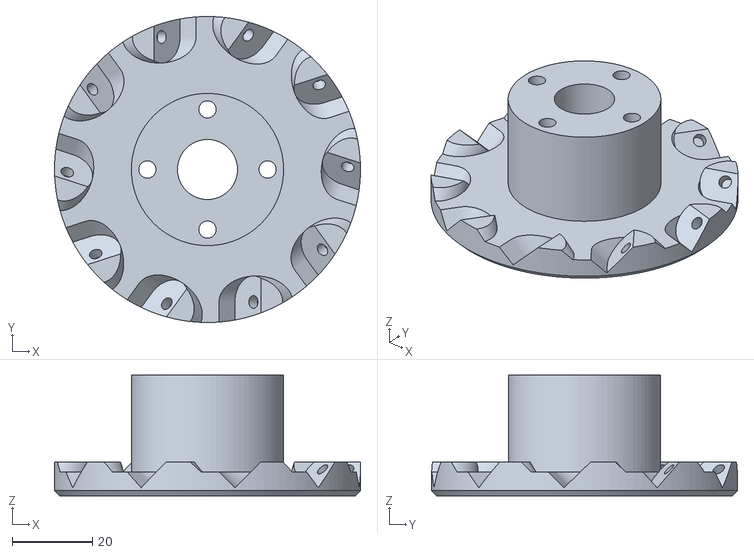
[picture p71: CAD file, 2023-12-12]
Modélisation/Roue Suédoise 3D/Roue face ext G.STL
76.4 x 76.4 x 30.2
