ValoulouEtGab/PolyMecanum/Modélisation/Plateforme/Triangles PolyMecanum.stl

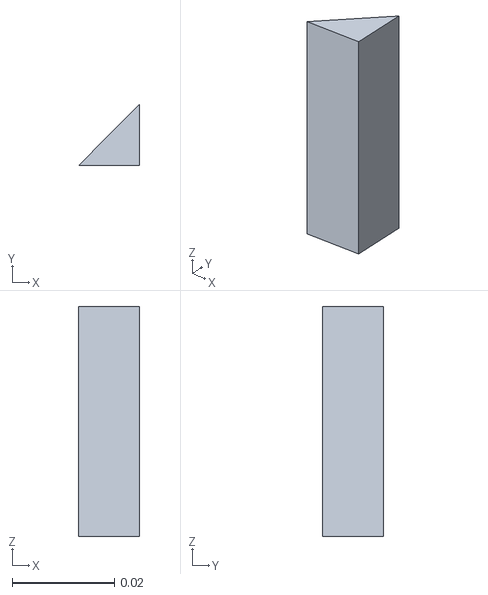
[picture p72: CAD file, 2024-01-22]
Modélisation/Plateforme/Triangles PolyMecanum.stl
0.012 x 0.012 x 0.045
