ValoulouEtGab/PolyMecanum/Modélisation/Roue Suédoise 3D/Roller.STL

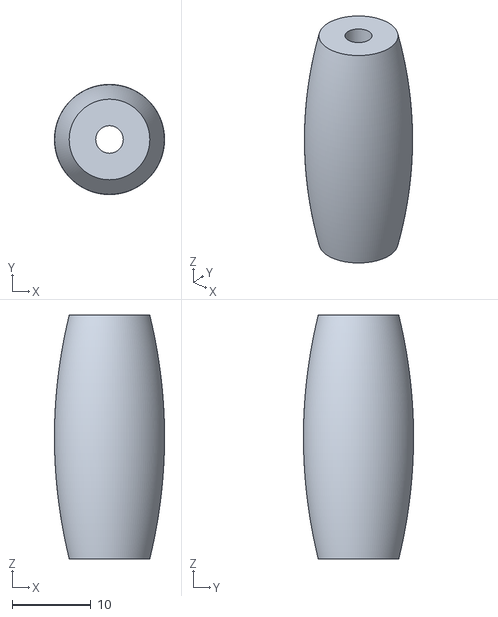
[picture p73: CAD file, 2023-12-12]
Modélisation/Roue Suédoise 3D/Roller.STL
14.0 x 14.0 x 31.0
