ValoulouEtGab/PolyMecanum/Modélisation/Plateforme/LogoPolytech.stl

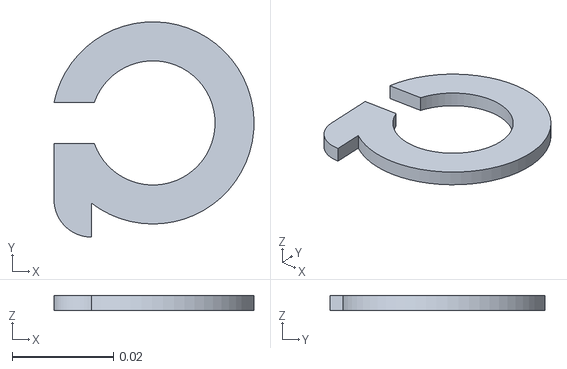
[picture p74: CAD file, 2024-01-22]
Modélisation/Plateforme/LogoPolytech.stl
0.0396 x 0.0426 x 0.003
