ValoulouEtGab/PolyMecanum/(list of files, cad)

Other CAD files:
Modélisation/Roue Suédoise 3D/Roue face int G.STL
Modélisation/Roue Suédoise 3D/Roue face ext D.STL
