ValoulouEtGab/PolyMecanum/Rapports de seances/8 - GIROD-ROUX.pdf

## RAPPORT DE SEANCE 8 :

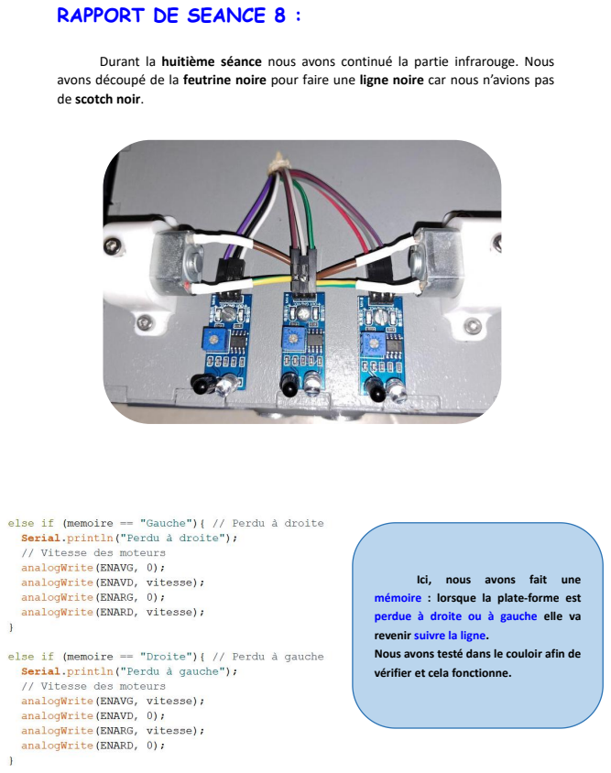
[picture p75: page 1]

Durant la huitième séance nous avons continué la partie infrarouge. Nous
avons découpé de la feutrine noire pour faire une ligne noire car nous n’avions pas
de scotch noir.

Ici, nous avons fait une
mémoire : lorsque la plate-forme est
perdue à droite ou à gauche elle va
revenir suivre la ligne. Nous avons testé dans le couloir afin de

vérifier et cela fonctionne.

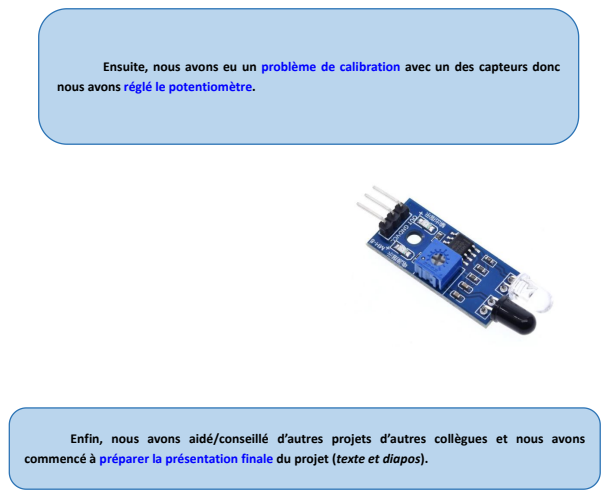
[picture p76: page 2]

Ensuite, nous avons eu un problème de calibration avec un des capteurs donc
nous avons réglé le potentiomètre.

Enfin, nous avons aidé/conseillé d’autres projets d’autres collègues et nous avons
commencé à préparer la présentation finale du projet (texte et diapos).
