ValoulouEtGab/PolyMecanum/Rapports de seances/5 - GIROD-ROUX.pdf

## RAPPORT DE SEANCE 5 :

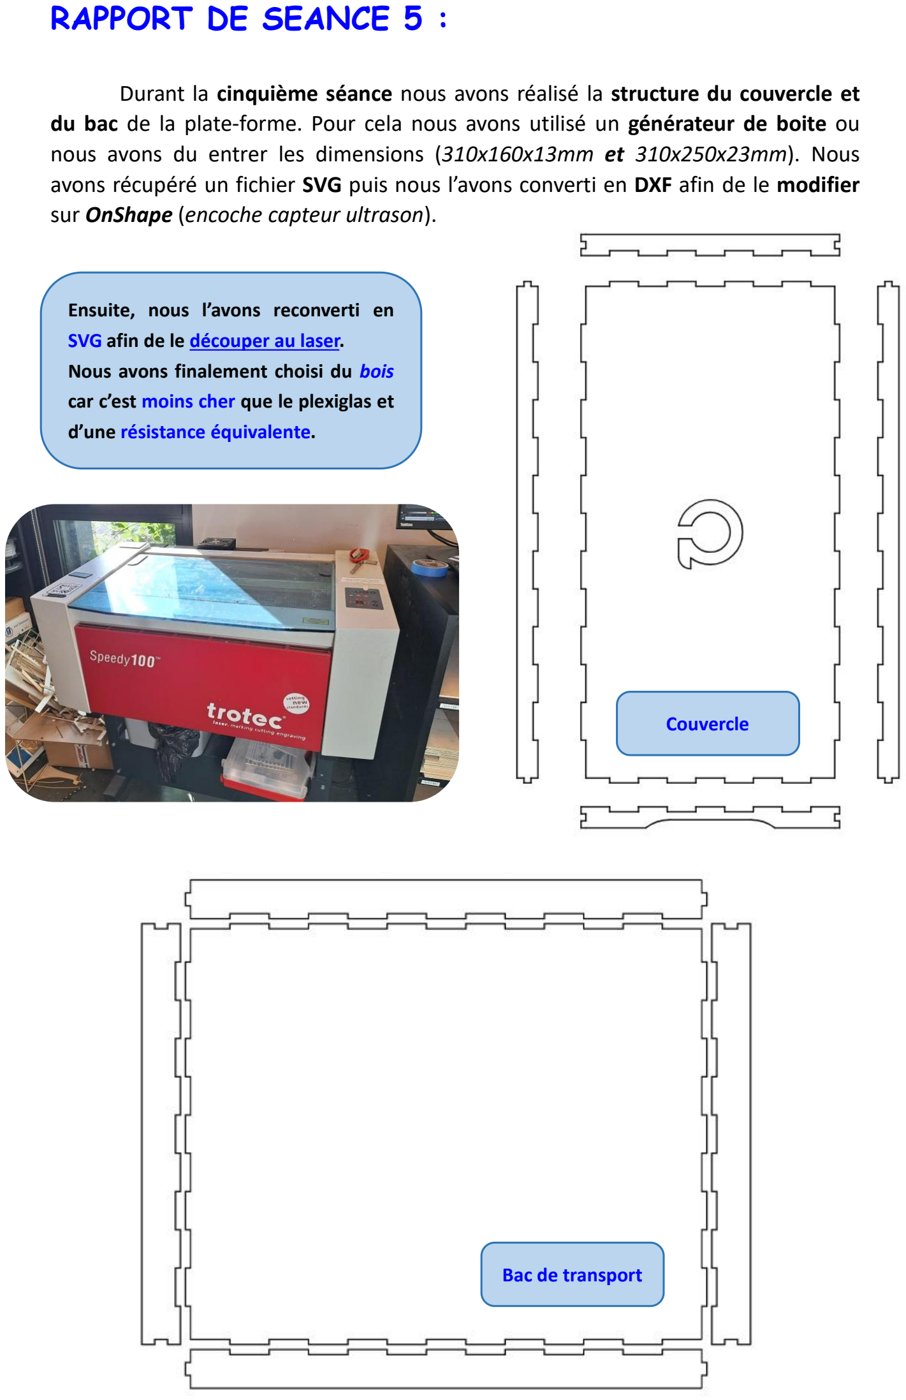
[picture p81: page 1]

Durant la cinquième séance nous avons réalisé la structure du couvercle et du bac de la plate-forme. Pour cela nous avons utilisé un générateur de boite ou nous avons du entrer les dimensions (310x160x13mm et 310x250x23mm). Nous avons récupéré un fichier SVG puis nous l’avons converti en DXF afin de le modifier sur OnShape (encoche capteur ultrason). Ensuite, nous l’avons reconverti en

SVG afin de le découper au laser. Nous avons finalement choisi du bois

car c’est moins cher que le plexiglas et d’une résistance équivalente.

Bac de transport

Couvercle

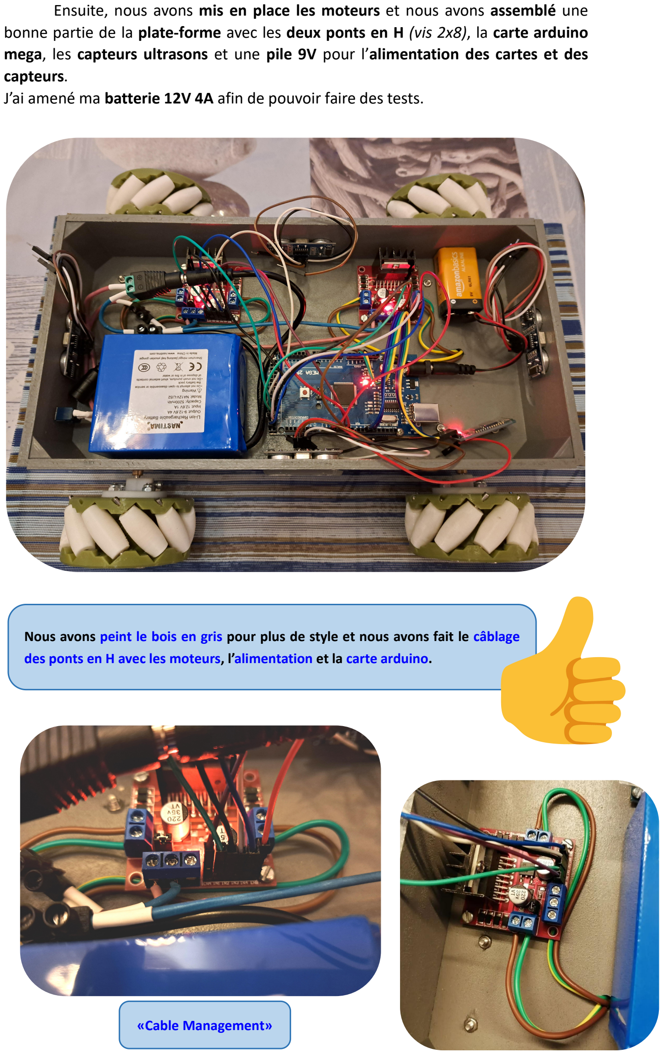
[picture p82: page 2]

Ensuite, nous avons mis en place les moteurs et nous avons assemblé une bonne partie de la plate-forme avec les deux ponts en H (vis 2x8), la carte arduino mega, les capteurs ultrasons et une pile 9V pour l’alimentation des cartes et des capteurs. J’ai amené ma batterie 12V 4A afin de pouvoir faire des tests.

Nous avons peint le bois en gris pour plus de style et nous avons fait le câblage des ponts en H avec les moteurs, l’alimentation et la carte arduino.

«Cable Management»

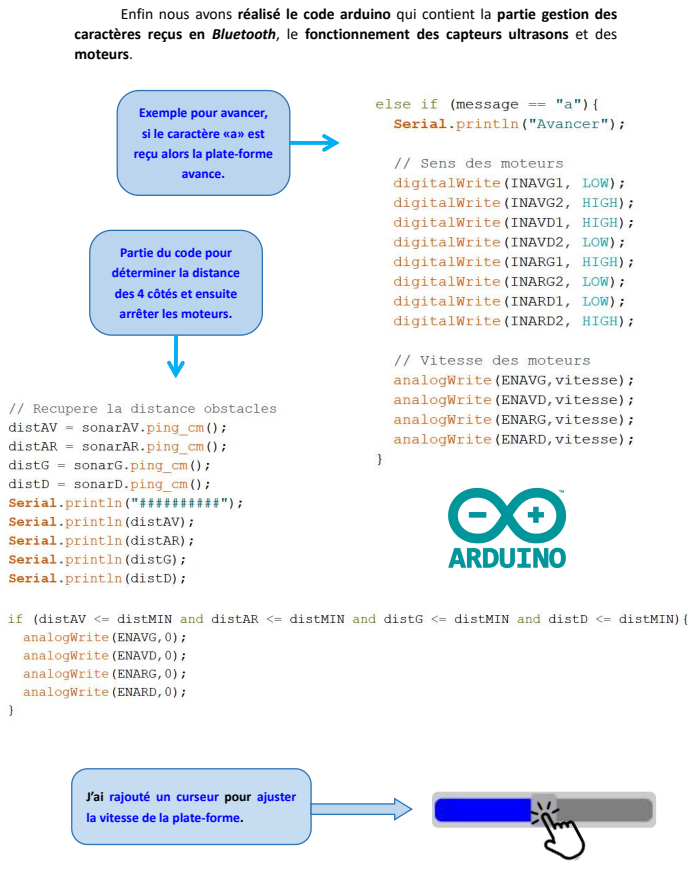
[picture p83: page 3]

Enfin nous avons réalisé le code arduino qui contient la partie gestion des
caractères reçus en Bluetooth, le fonctionnement des capteurs ultrasons et des
moteurs. Exemple pour avancer, si le caractère «a» est

reçu alors la plate-forme
avance. Partie du code pour

déterminer la distance
des 4 côtés et ensuite
arrêter les moteurs.

J’ai rajouté un curseur pour ajuster
la vitesse de la plate-forme.

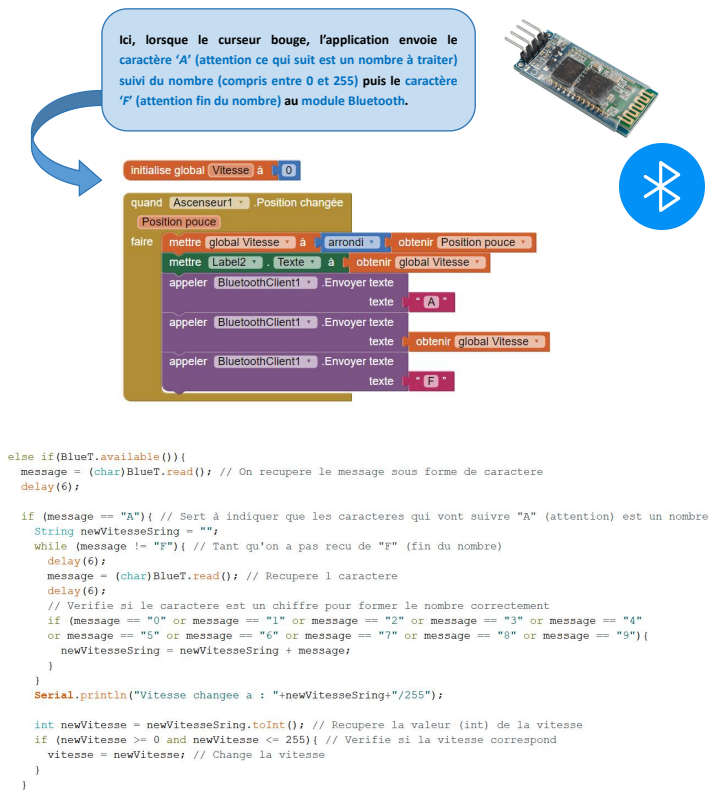
[picture p84: page 4]

Ici, lorsque le curseur bouge, l’application envoie le
caractère ‘A’ (attention ce qui suit est un nombre à traiter)
suivi du nombre (compris entre 0 et 255) puis le caractère
‘F’ (attention fin du nombre) au module Bluetooth.
