ValoulouEtGab/PolyMecanum/(list of files, drawings)

Other design files:
Modélisation/Montage vue generale.fzz
