ValoulouEtGab/PolyMecanum/(commit log)

2023-12-12 Create Rapports de seances
2023-12-12 Rename 1 - GIROD-ROUX.pdf to Rapoorts de séance/1 - GIROD-ROUX.pdf
2023-12-12 Create Rapports de séance
2023-12-12 Delete Rapoorts de séance/1 - GIROD-ROUX.docx
    jhjk
