ValoulouEtGab/PolyMecanum/Images/20240202_102033.jpg

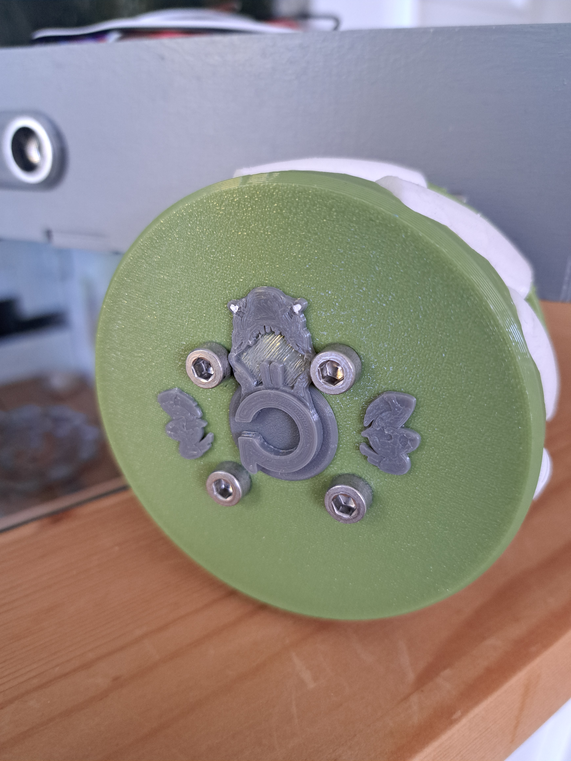
Images/20240202_102033.jpg
